ECE411T5/Practicum/Initial Prototype/KeyPad DoorLock Initial Prototype.jpg

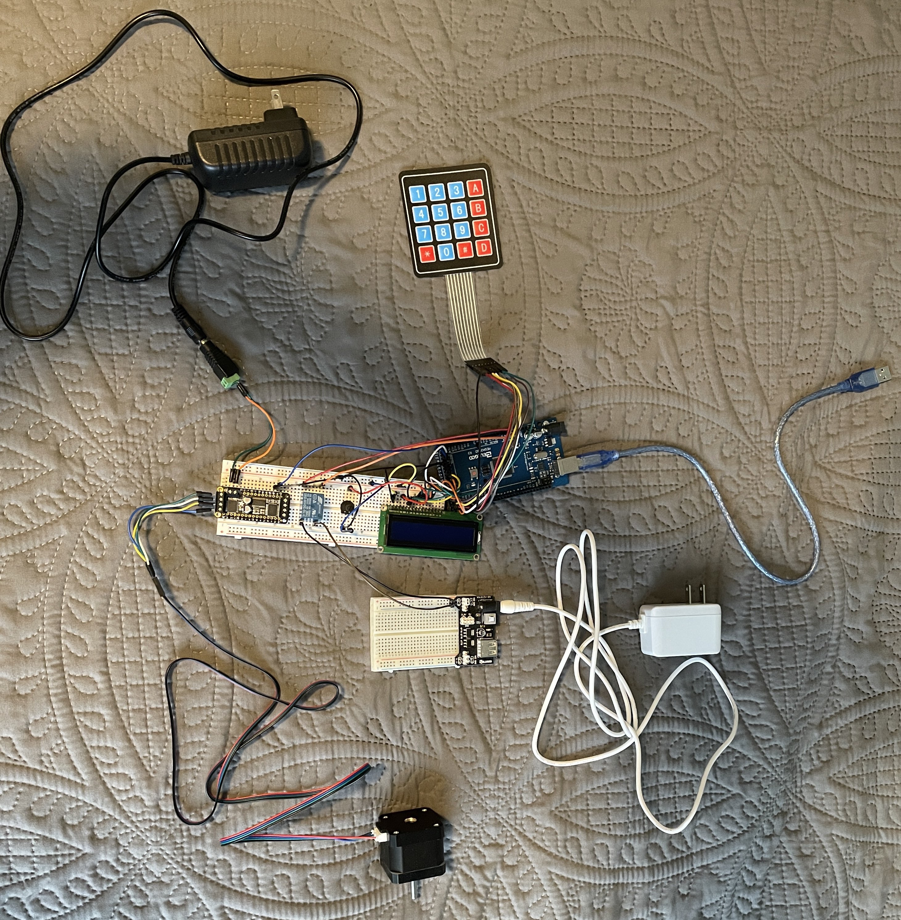
Initial Prototype/KeyPad DoorLock Initial Prototype.jpg
