ECE411T5/Practicum/README.md

# Practicum
Portland State University. Electrical and Computer Engineering Department. ECE 411 Practicum Project

## Team 5
* jdhobby       - Joshua Hobby
* CompileMyLife - Ibrahim Binmahfood
* Ghonimo       - Mohamed Ghonim
* DrFumador     - Mohamed Ashkanani
