ECE411T5/Practicum/Product Design Specifications PDS/System Architecture.pdf

ECE 411 Industry Design Processes System Architecture

Mohamed Ghonim, Ibrahim Binmahfood Joshua Hobby, Mohamed Ashkanani Team #5

Block diagram of our system.

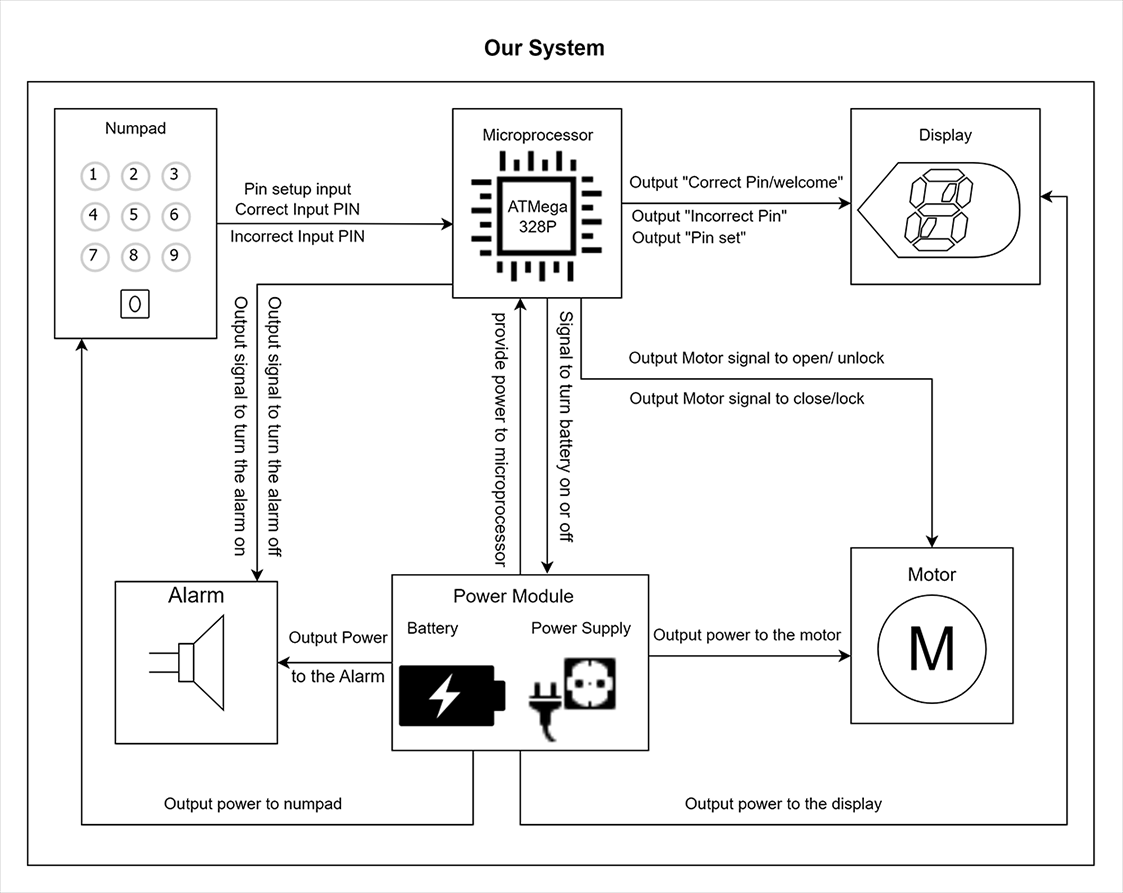
[picture p3: figure]

Block diagram of our system. (2)

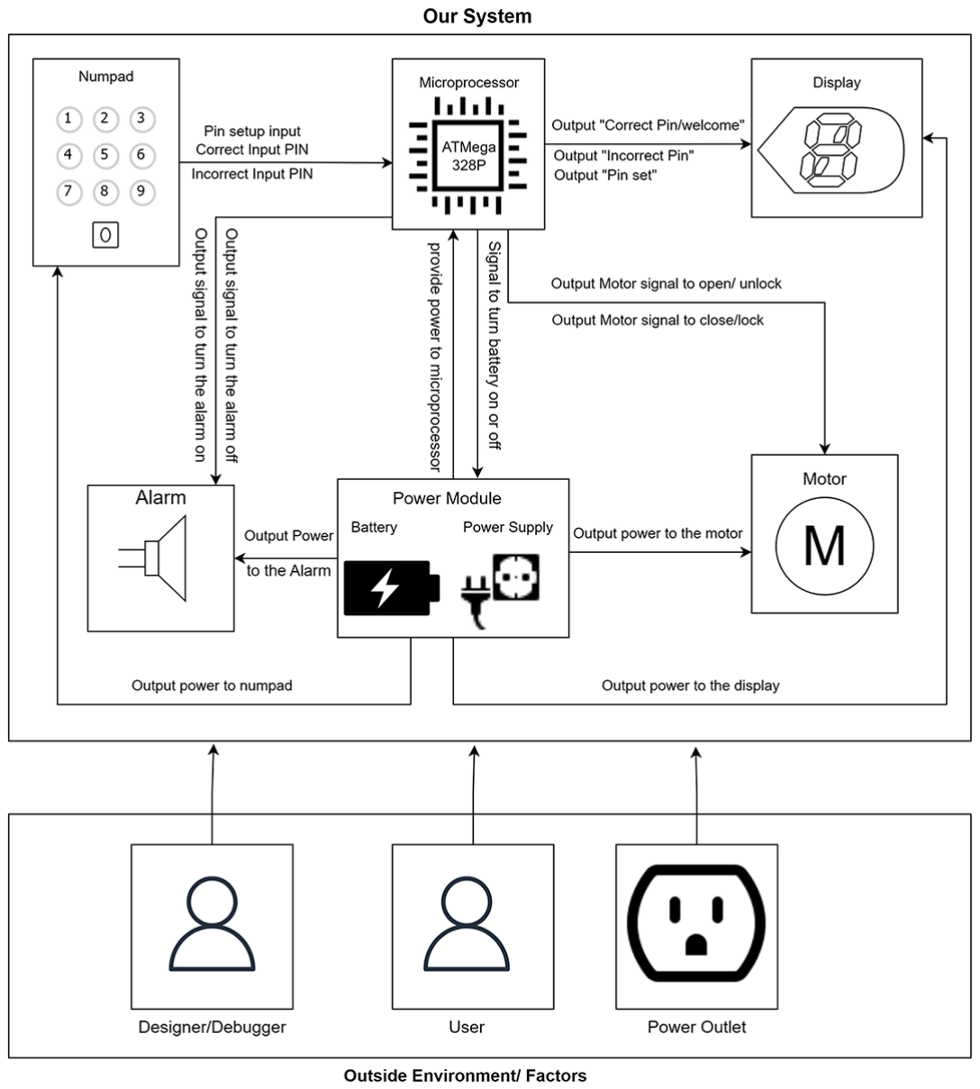
[picture p4: figure]

Block diagram with our “potential” fingerprint sensor additional feature.

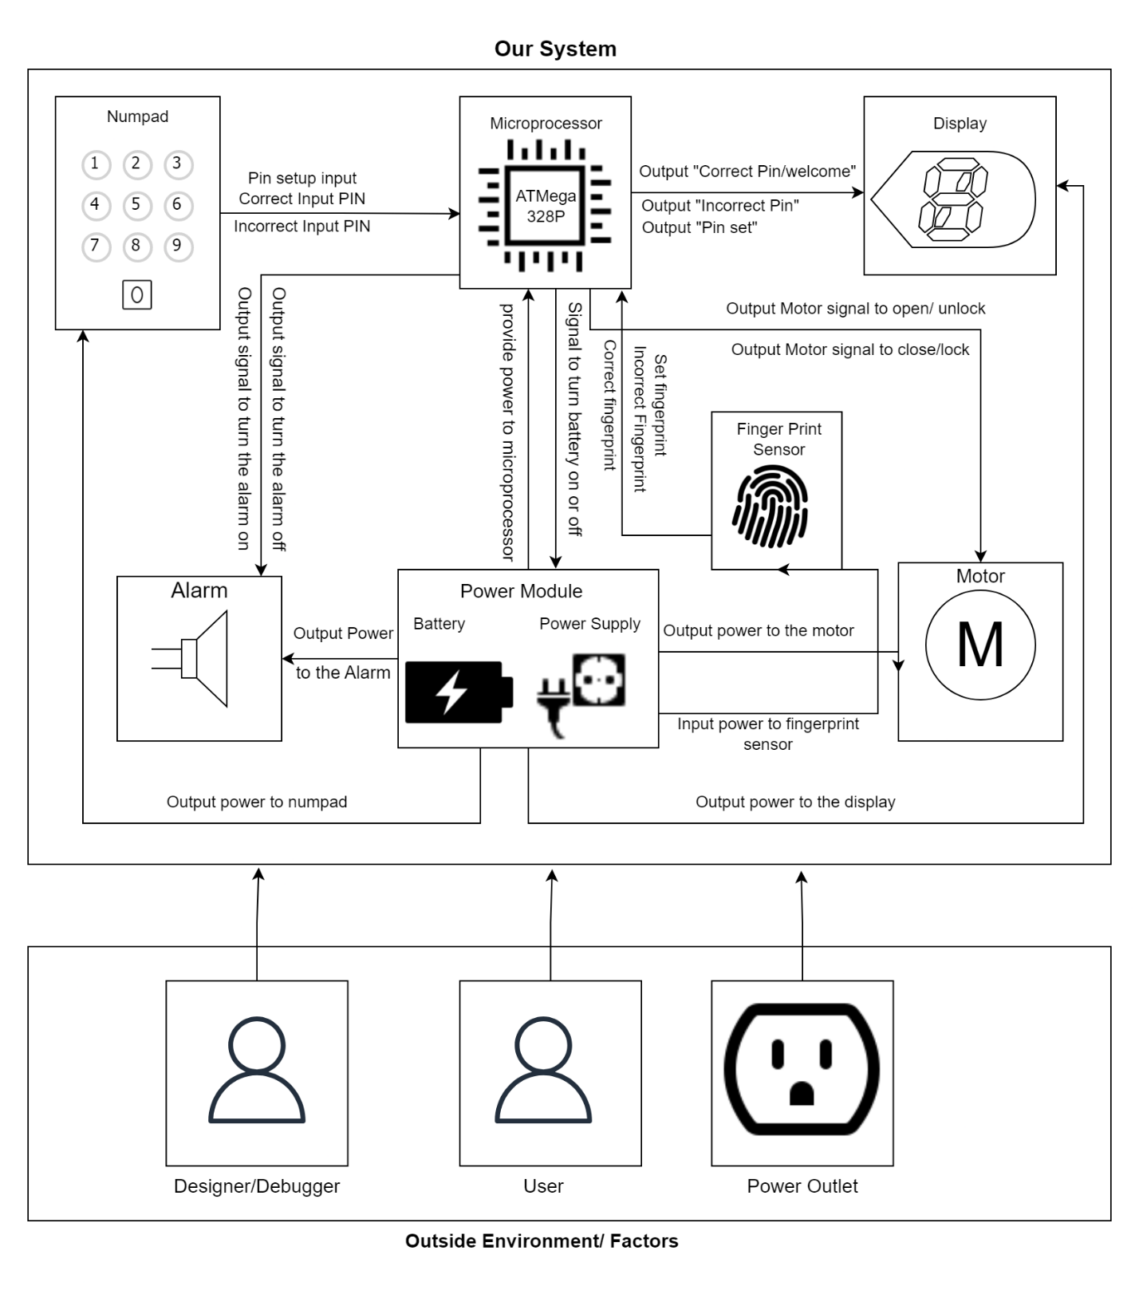
[picture p5: figure]
