ECE411T5/Practicum/ECE411_schedule.pdf

ECE411 Practicum Project | Dec 8, 2022
Portland State University | http://github.com/ECE411T5/Practicum
Project manager | Joshua Hobby, Mohamed Ghonim, Ibrahim Binmahfood, Mohamed Ashkanani
Project dates | Oct 31, 2022 - Dec 9, 2022
Completion | 89%
Tasks | 18
Resources | 4

Name | Begin date | End date
Set Gantt Chart | 10/31/22 | 10/31/22
Breadboard Prototype | 11/1/22 | 11/3/22
Updated Schematic and Layout | 11/2/22 | 11/3/22
Rough Programming | 11/3/22 | 11/11/22
Finalize BOM | 11/3/22 | 11/8/22
CAD draft Draft looks good. Design Review went well. | 11/7/22 | 11/9/22
Functional Decomposition | 11/8/22 | 11/9/22
Order missing parts for BOM | 11/9/22 | 11/10/22
Finalize programming FInal code uploaded | 11/14/22 | 11/21/22
CAD finalized | 11/10/22 | 11/14/22
Verify all parts recieved | 11/15/22 | 11/21/22
3d Print Enclosure Late. Got final print 12/6 | 11/15/22 | 11/22/22
Design Review | 11/16/22 | 11/17/22
Send PCB design to lab | 11/17/22 | 11/17/22
Construct Circuit PCB came in late. Could not start constructing on time. Issues with construction. Power supply adaptor missing. | 11/21/22 | 11/25/22
Test plan design Documentation on Github for test plans | 11/22/22 | 11/29/22
Test project Troubleshooting issues with implementing ATMega328 on PCB. MIcrocontroller works on Arduino,but does not transfer to board well. | 11/30/22 | 12/6/22
Final Presentation | 12/7/22 | 12/8/22
ECE411 Practicum Project | Dec 8, 2022
Tasks | 2

Name | Default role
Joshua Hobby | project manager
Mohamed Ghonim | project manager
Ibrahim Binmahfood | project manager
Mohamed Ashkanani | project manager

## Resources

## Gantt Chart

Name | Begin date | End date
Set Gantt Chart | 10/31/22 | 10/31/22
Breadboard Prototype | 11/1/22 | 11/3/22
Updated Schematic and Layout | 11/2/22 | 11/3/22
Rough Programming | 11/3/22 | 11/11/22
Finalize BOM | 11/3/22 | 11/8/22
CAD draft | 11/7/22 | 11/9/22
Functional Decomposition | 11/8/22 | 11/9/22
Order missing parts for BOM | 11/9/22 | 11/10/22
Finalize programming | 11/14/22 | 11/21/22
CAD finalized | 11/10/22 | 11/14/22
Verify all parts recieved | 11/15/22 | 11/21/22
3d Print Enclosure | 11/15/22 | 11/22/22
Design Review | 11/16/22 | 11/17/22
Send PCB design to lab | 11/17/22 | 11/17/22
Construct Circuit | 11/21/22 | 11/25/22
Test plan design | 11/22/22 | 11/29/22
Test project | 11/30/22 | 12/6/22
Final Presentation | 12/7/22 | 12/8/22
10'22 November 2022 | December 2022

31

1

2

3
4

7

8

9 | 10 | 11 | 14 | 15 | 16 | 17 | 18 | 21 | 22 | 23 | 24 | 25 | 28 | 29 | 30

1

2
5

6
7

8

9 | 12 | 13 | 14 | 15 | 16
Set Gantt Chart | Functional Decomposition | Finalize programming | Construct Circuit | Test project

## Resources Chart

Name | Default role
Joshua Hobby | project man...

Set Gantt Chart

Final Presentation

Order missing parts for B...

Verify all parts recieved

Design Review

Construct Circuit

Test plan design

Test project

Functional Decomposition

Rough Programming

Finalize programming

Mohamed Ghonim | project man...

Updated Schematic and ...

Final Presentation

Order missing parts for B...

Design Review

Test plan design

Test project

Functional Decomposition

CAD finalized

Send PCB design to lab

Finalize programming

Ibrahim Binmahfood | project man...

Breadboard Prototype

200% | 200% | 200% | 200% | 300%
200% | 300% | 200% | 200% | 200%
200% | 200% | 200% | 300% | 200% | 200%
10'22 November 2022 | December 2022
31 1 2 3 4 | 7 8 9 10 11 | 14 15 16 17 18 | 21 22 23 24 25 | 28 29 30 1 2 | 5 6 7 8 9 | 12 13 14 15 16
| 200% 300% 200% | 200% 300% 200% | 300% 200%
