ECE411T5/Practicum/0 - Final CAD V2.3.1/3 - CAD DRC-ERC Pics/No_ERC_Violations.jpg

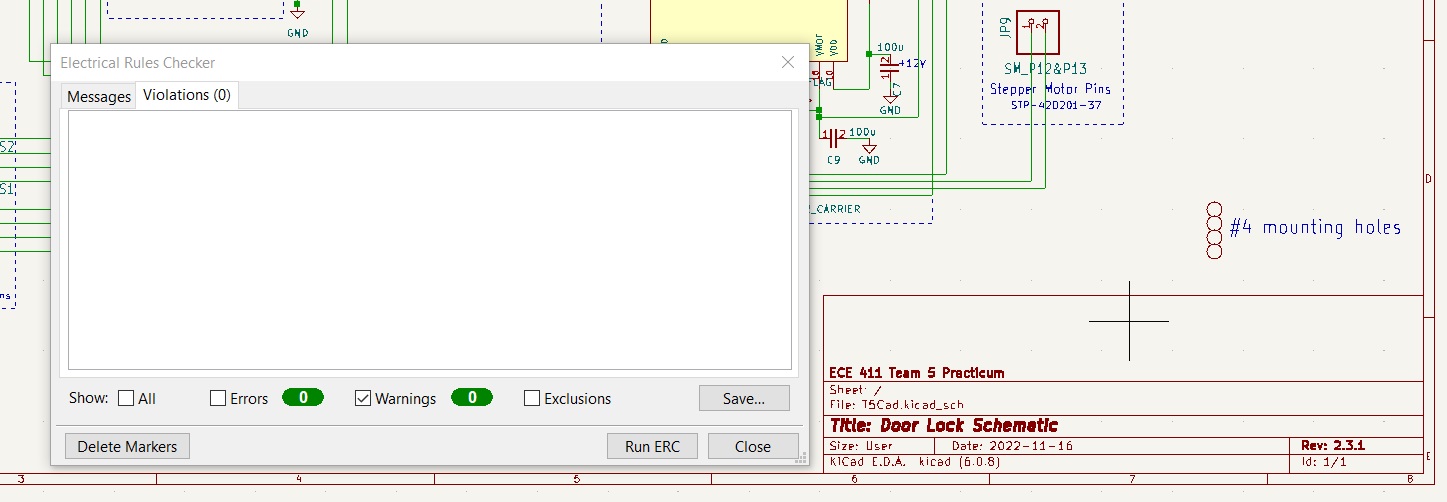
0 - Final CAD V2.3.1/3 - CAD DRC-ERC Pics/No_ERC_Violations.jpg
