ECE411T5/Practicum/0 - Final CAD V2.3.1/3 - CAD DRC-ERC Pics/Schematic Screenshot.jpg

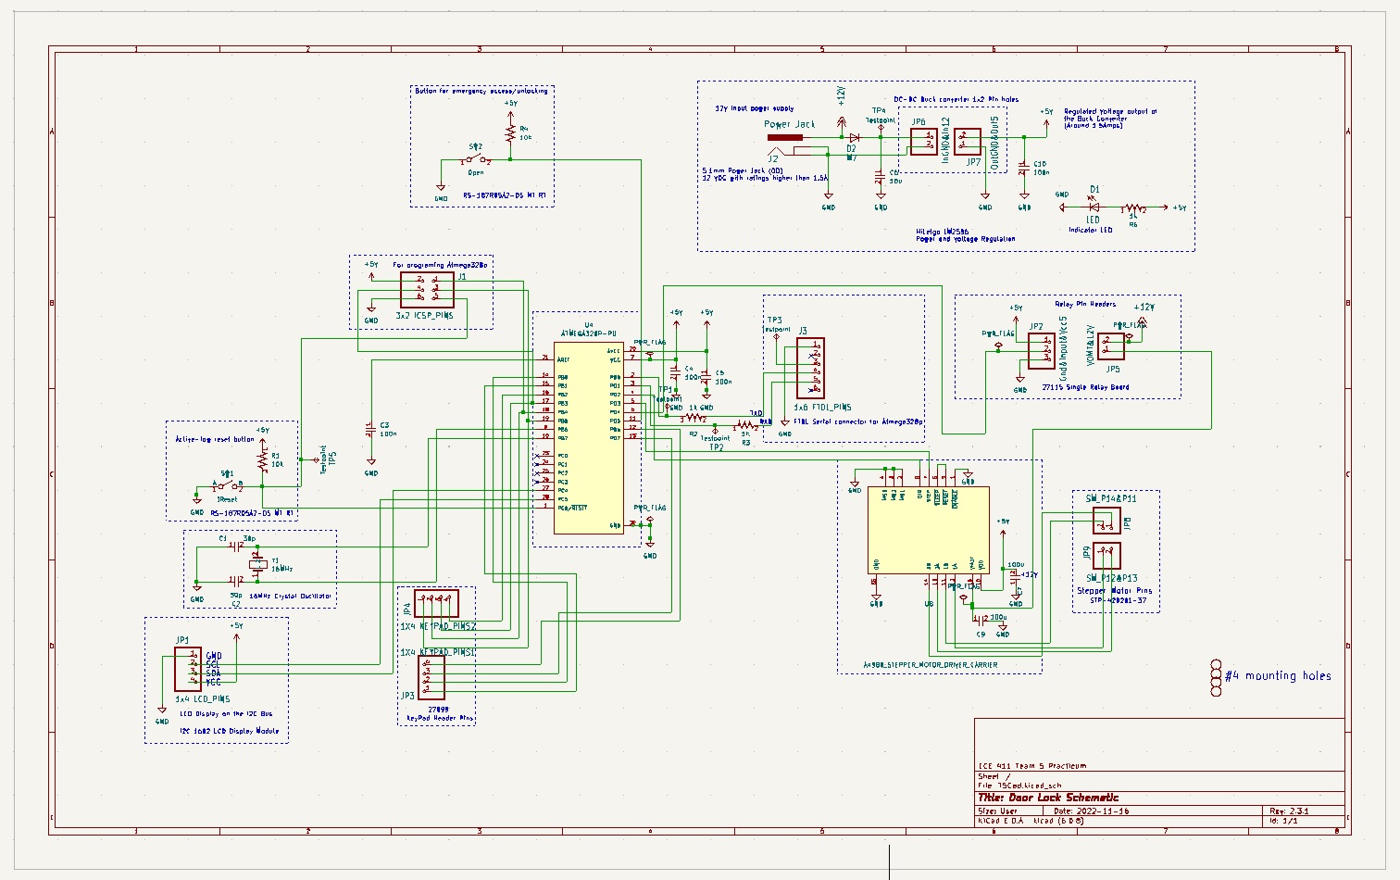
0 - Final CAD V2.3.1/3 - CAD DRC-ERC Pics/Schematic Screenshot.jpg
