ECE411T5/Practicum/Level 1 Block Diagrams/Door Lock with Alarm Block DiagramC.png

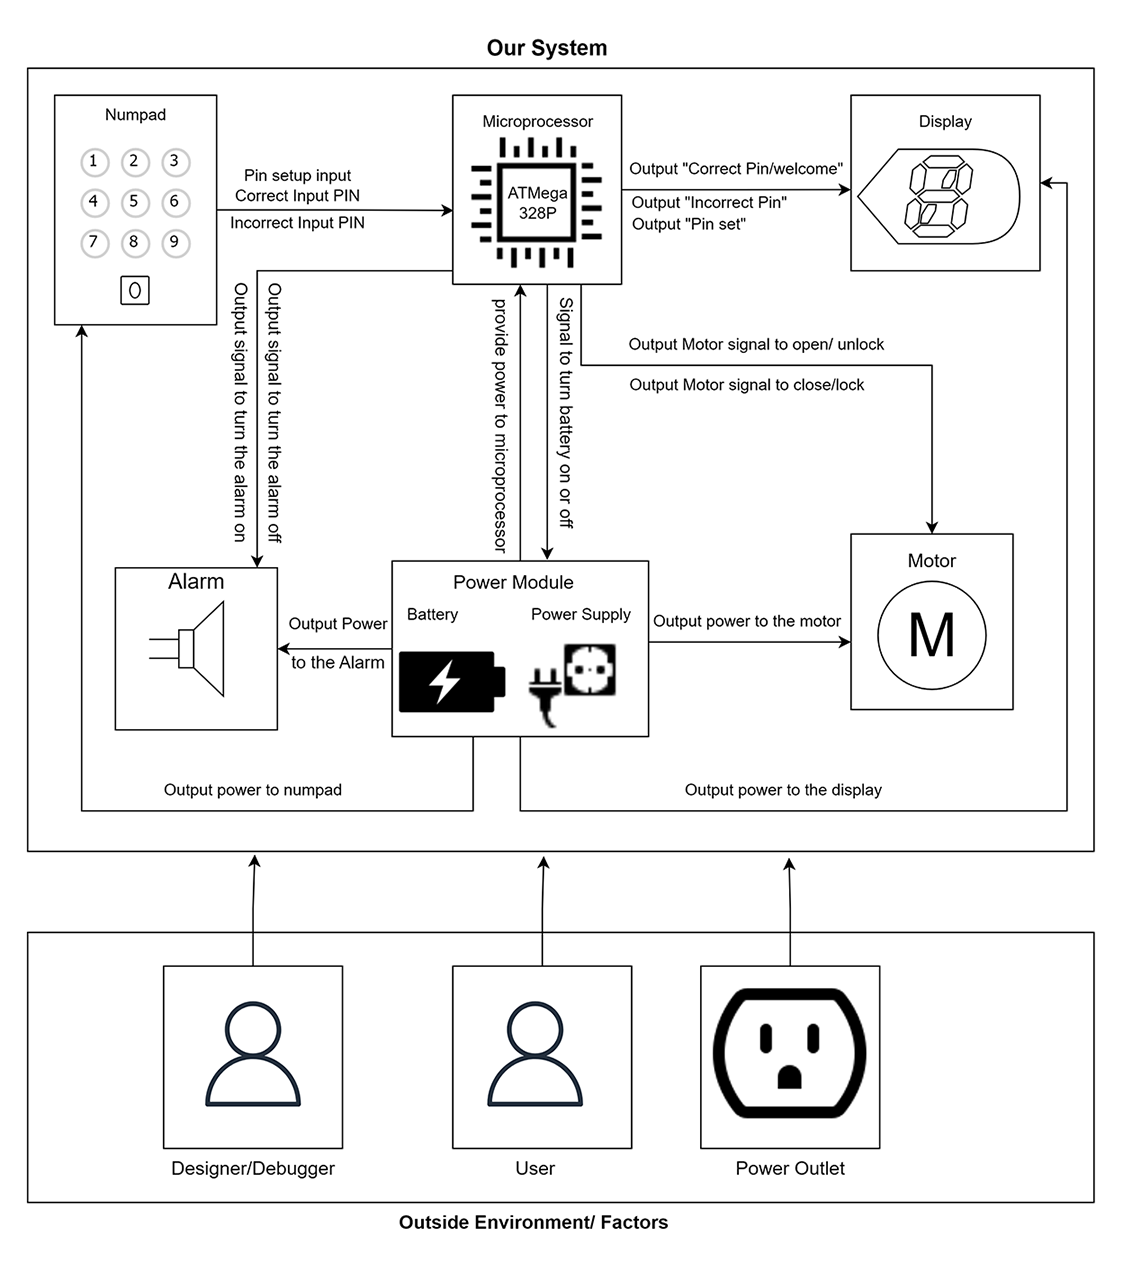
Level 1 Block Diagrams/Door Lock with Alarm Block DiagramC.png
