ECE411T5/Practicum/PCB Layout/Preliminary_3D_Layout_Back.png

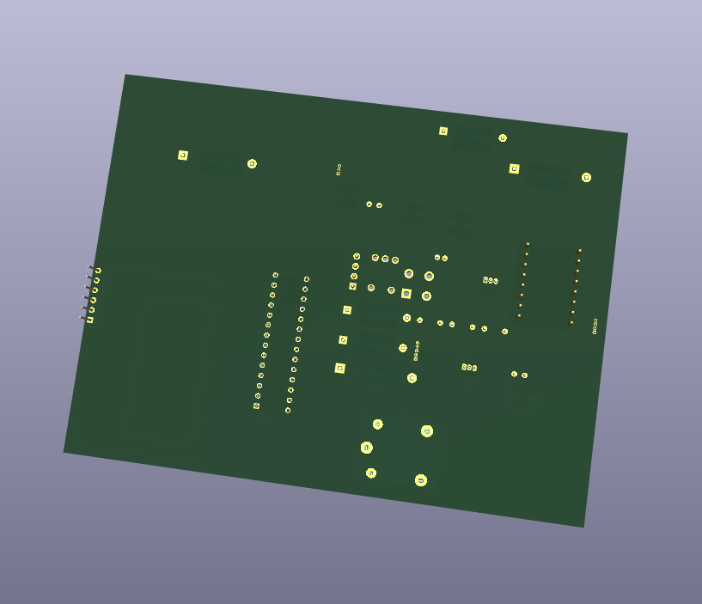
PCB Layout/Preliminary_3D_Layout_Back.png
