ECE411T5/Practicum/PCB Layout/Preliminary_3D_Layout_Front.png

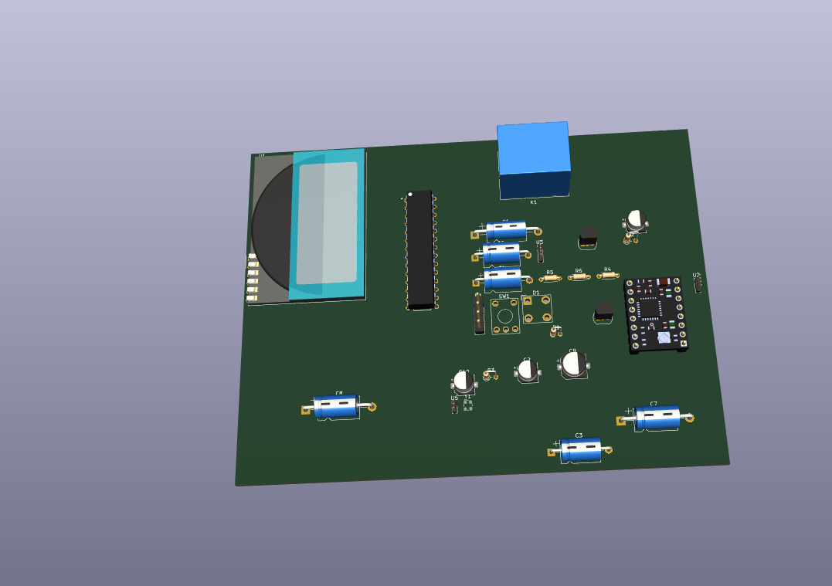
PCB Layout/Preliminary_3D_Layout_Front.png
