ECE411T5/Practicum/PCB Layout/Preliminary_PCB.jpg

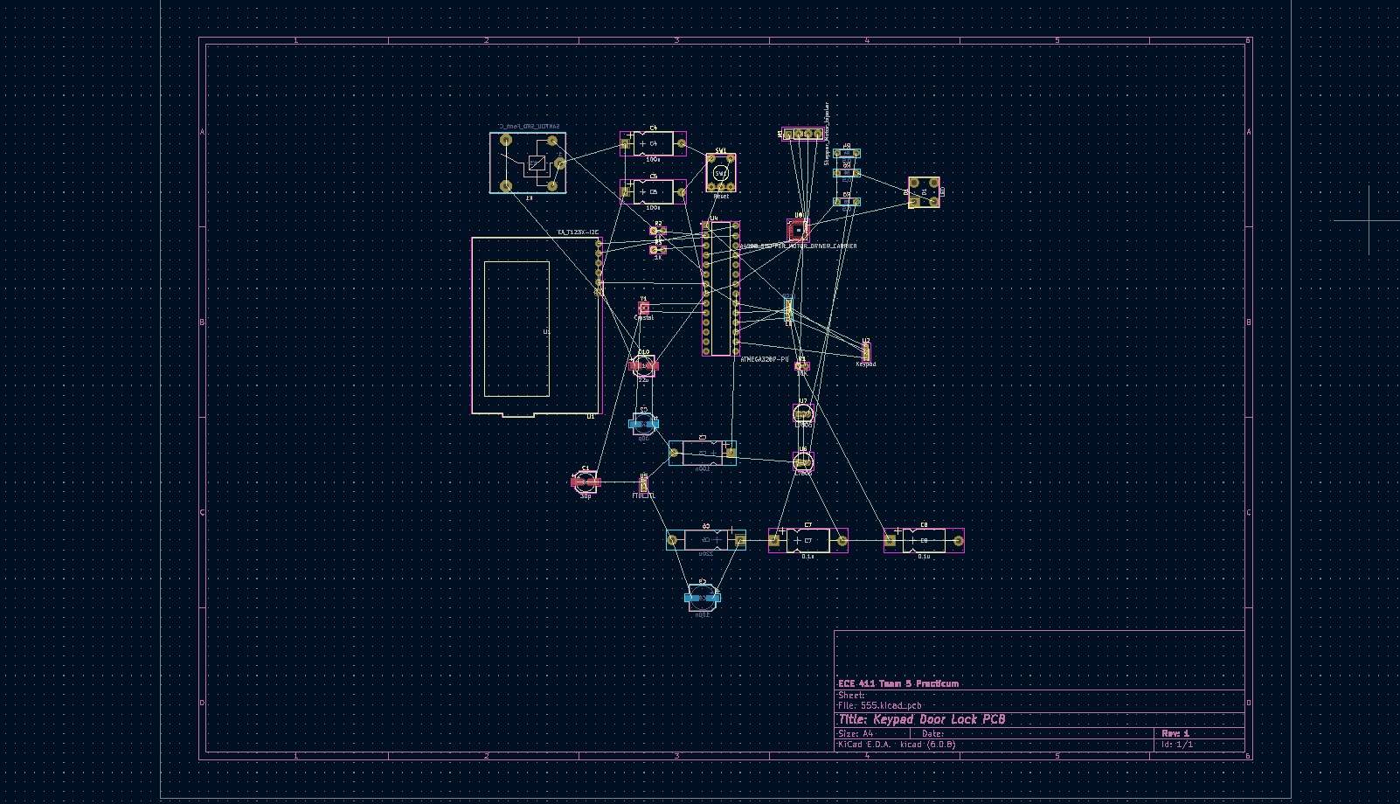
PCB Layout/Preliminary_PCB.jpg
