ECE411T5/Practicum/Updated Schematic/No_errors.png

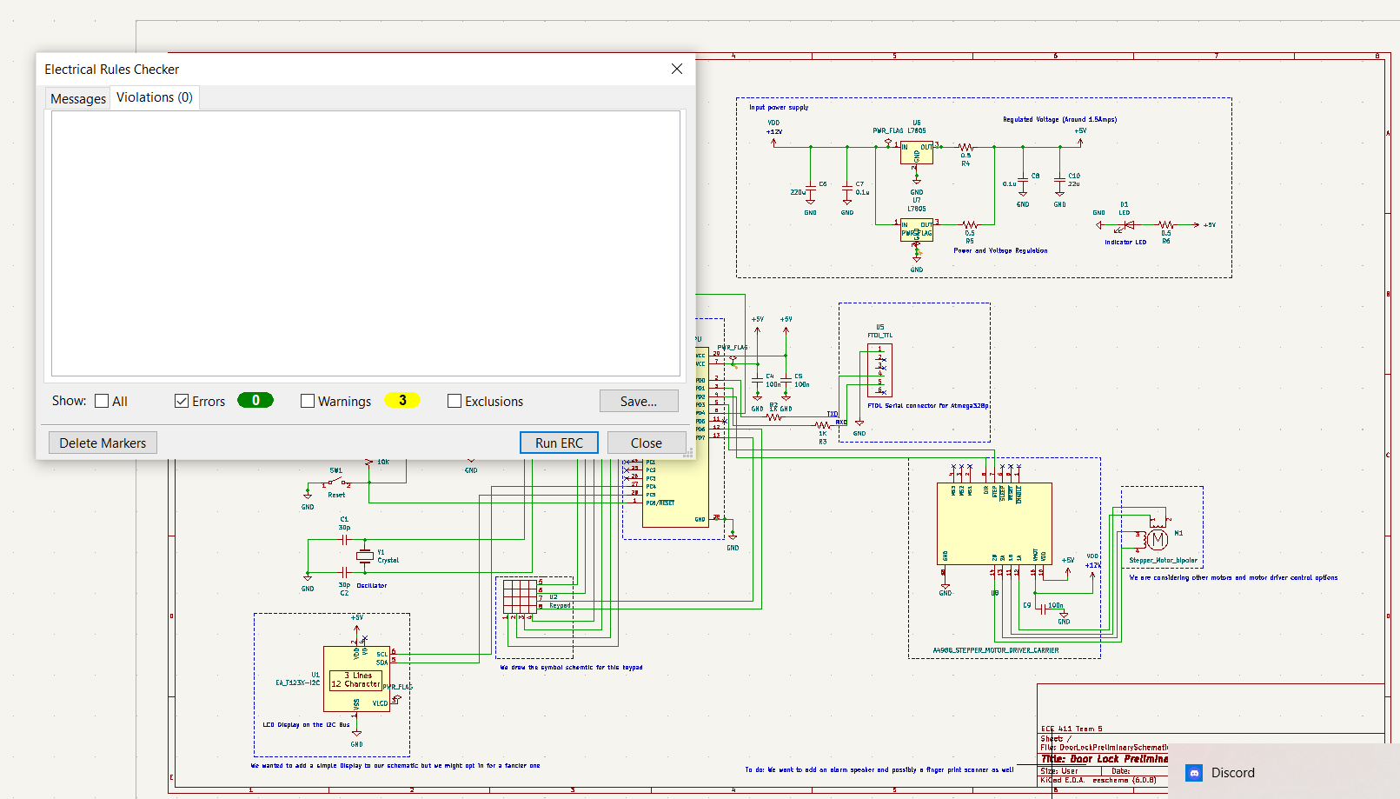
Updated Schematic/No_errors.png
