ECE411T5/Practicum/Bill Of Materials (BOM)/ECE 411 - BOM - Revision#4 - Team 5.xlsx

Bill Of Materials for: [Practicum Group 5] [TEAM NAME]
Last modified: [12/08/2022]
PCB version: [PCB VERSION #4]
BOM revision: [BOM REVISION #4] |  | P/NP | = Place/Not Place (components marked NP are not stuffed on the board)
Cnt | Part References | P/NP | Mfg | Device | Mfg PN | Description | Dist | Dist Part Number | Cost Ea. | Cost Total
1 | U4 | P | Microchip | ATMEGA328P-PU | ATMEGA328P-PU | MICROCONTROLLER | Amazon | N/A | $13.50 | $13.50
1 | U1 | P | JOYNANO | Stepper motor | N/A | JoyNano Nema 17 Stepper Motor Integrated 310mm T8 Lead Screw | Amazon | ‎M42SH40-1684A | $12.99 | $12.99
1 | U2 | P | Pololu | A4988_STEPPER_MOTOR_DRIVER_CARRIER | 1182 | Stepper motor controler; IC: A4988; 1A; Uin mot: 8÷35V | Pololu | 1182 | $14.45 | $14.45
1 | U4 | P | Parallax | Single Relay Board | 27115 | Single Relay Board | Mouser | 619-27115 | $9.99 | $9.99
2 | IC1, IC2 | P | Texas Instruments | LM7805S/NOPB | LM7805S/NOPB | IC REG LINEAR 5V 1.5A | Digi-key | 296-49741-ND | $2.27 | $4.54
1 | U2 | P | GeeekPi | 16x2 White on Blue Character LCD | N/A | 16x2 White on Blue Character LCD | Amazon | N/A | $10.99 | $10.99
1 | U3 | P | Parallax | KEYPAD4X4 | 27899 | SWITCH KEYPAD 16 KEY NON-ILLUM | Crystalfontz | CFAH1602B-TMI-JT | $7.95 | $7.95
1 | D2 | P | Würth Elektronik | LEDCHIP-LED0805 | 150080GS75000 | LED | Mouser | 710-150080GS75000 | $0.19 | $0.19
1 | SW1 | P | C&K | SWITCH-MOMENTARY-2SMD | RS-187R05A2-DS MT RT | Various NO switches- pushbuttons, reed, etc | Digi-key | CKN10361TR-ND | $0.64 | $0.64
1 | SW2 | P | C&K | SWITCH-MOMENTARY-2SMD | RS-187R05A2-DS MT RT | Various NO switches- pushbuttons, reed, etc | Digi-key | CKN10361TR-ND | $0.64 | $0.64
1 | X1 | P | ECS | CRYSTALSMD-HC49UP | ECS-160-18-5PX-TR | Crystals (Generic) | Digi-key | XC2081TR-ND | $0.45 | $0.45
2 | R1, R2 | P | Yageo | R-US_R0805 | RC0805FR-0710KL | 10 kOhms ±1% 0.125W, 1/8W Chip Resistor 0805 (2012 Metric) Moisture Resistant Thick Film | Digi-key | 311-10.0KCRTR-ND | $0.10 | $0.20
3 | R3, R4, R5 | P | Yageo | R-US_R0805 | RC0805FR-071KL | RES 1K OHM 1% 1/8W 0805 | Digi-key | 311-1.00KCRTR-ND | $0.10 | $0.30
4 | C1, C2, C3, C4 | P | Samsung Electro-Mechanics | C-EUC0805K | CL21B104KBCNNNC | CAP CER 100nF 50V X7R 0805 | Digi-key | 1276-1003-2-ND | $0.10 | $0.40
2 | C5, C6 | P | Samsung Electro-Mechanics | C-EUC0805K | CL32Z107MQV6PNE | CAPACITOR, European symbol | Digi-key | 1276-CL32Z107MQV6PNETR-ND | $0.10 | $0.20
1 | C7 | P | Samsung Electro-Mechanics | C-EUC0805K | CL31B106KLHNNNE | 10 µF ±10% 35V Ceramic Capacitor X7R 1206 (3216 Metric) | Digi-key | 1276-3103-2-ND | $0.66 | $0.66
2 | C8, C9 | P | Samsung Electro-Mechanics | C-EUC0805K | CL21C300JBANNNC | CAP CER 30PF 50V C0G/NP0 0805 | Digi-key | 1276-1130-2-ND | $0.10 | $0.20
1 | J1 | P | Harwin | PINHD-2X3 | M20-9980345 | PIN HEADER | Digi-key | 952-2120-ND | $0.34 | $0.34
1 | J2 | P | Sullins | PINHD-1X6 | PRPC006SAAN-RC | PIN HEADER | Digi-key | S1011EC-06-ND | $0.19 | $0.19
1 | J1 | P | HiLetgo | LM2596 Adjustable DC-DC Step Down Buck Power Convert | N/A | Power Converter Module 4.0-40V to 1.25-37V LED Voltemeter | Amazon | N/A | $5.25 | $5.25
1 | J3 | P | HiLetgo | AVR ISP | N/A | USBTiny USBtinyISP AVR ISP Programmer 6/10 Pin Bootloader for Arduino UNO MEGA | Amazon | N/A | $9.19 | $9.19
1 | Exterior | P | EPL | 3D printed eterior for the device | N/A | A small 3D printed device with hole for the getting power and the LCD display | EPL | N/A | $8.00 | $8.00
 |  |  |  |  |  |  |  |  | Sum | $93.26
VERSION INFO
Rev | Date | Notes
1.0r3 | 2022-12-08 | Add some new components to the list
1.0r2 | 2022-11-20 | Update some wrong components
1.0r1 | 2022-11-10 | Cleaned up parts, fixed mistakes, rough draft of board
1.0r0 | 2022-10-31 | Initial BOM, an simple list of all the components required. Dist Part Number and cost were not determined
