ECE411T5/Practicum/Preliminary Schematic/Door Lock Preliminary Schematic.pdf

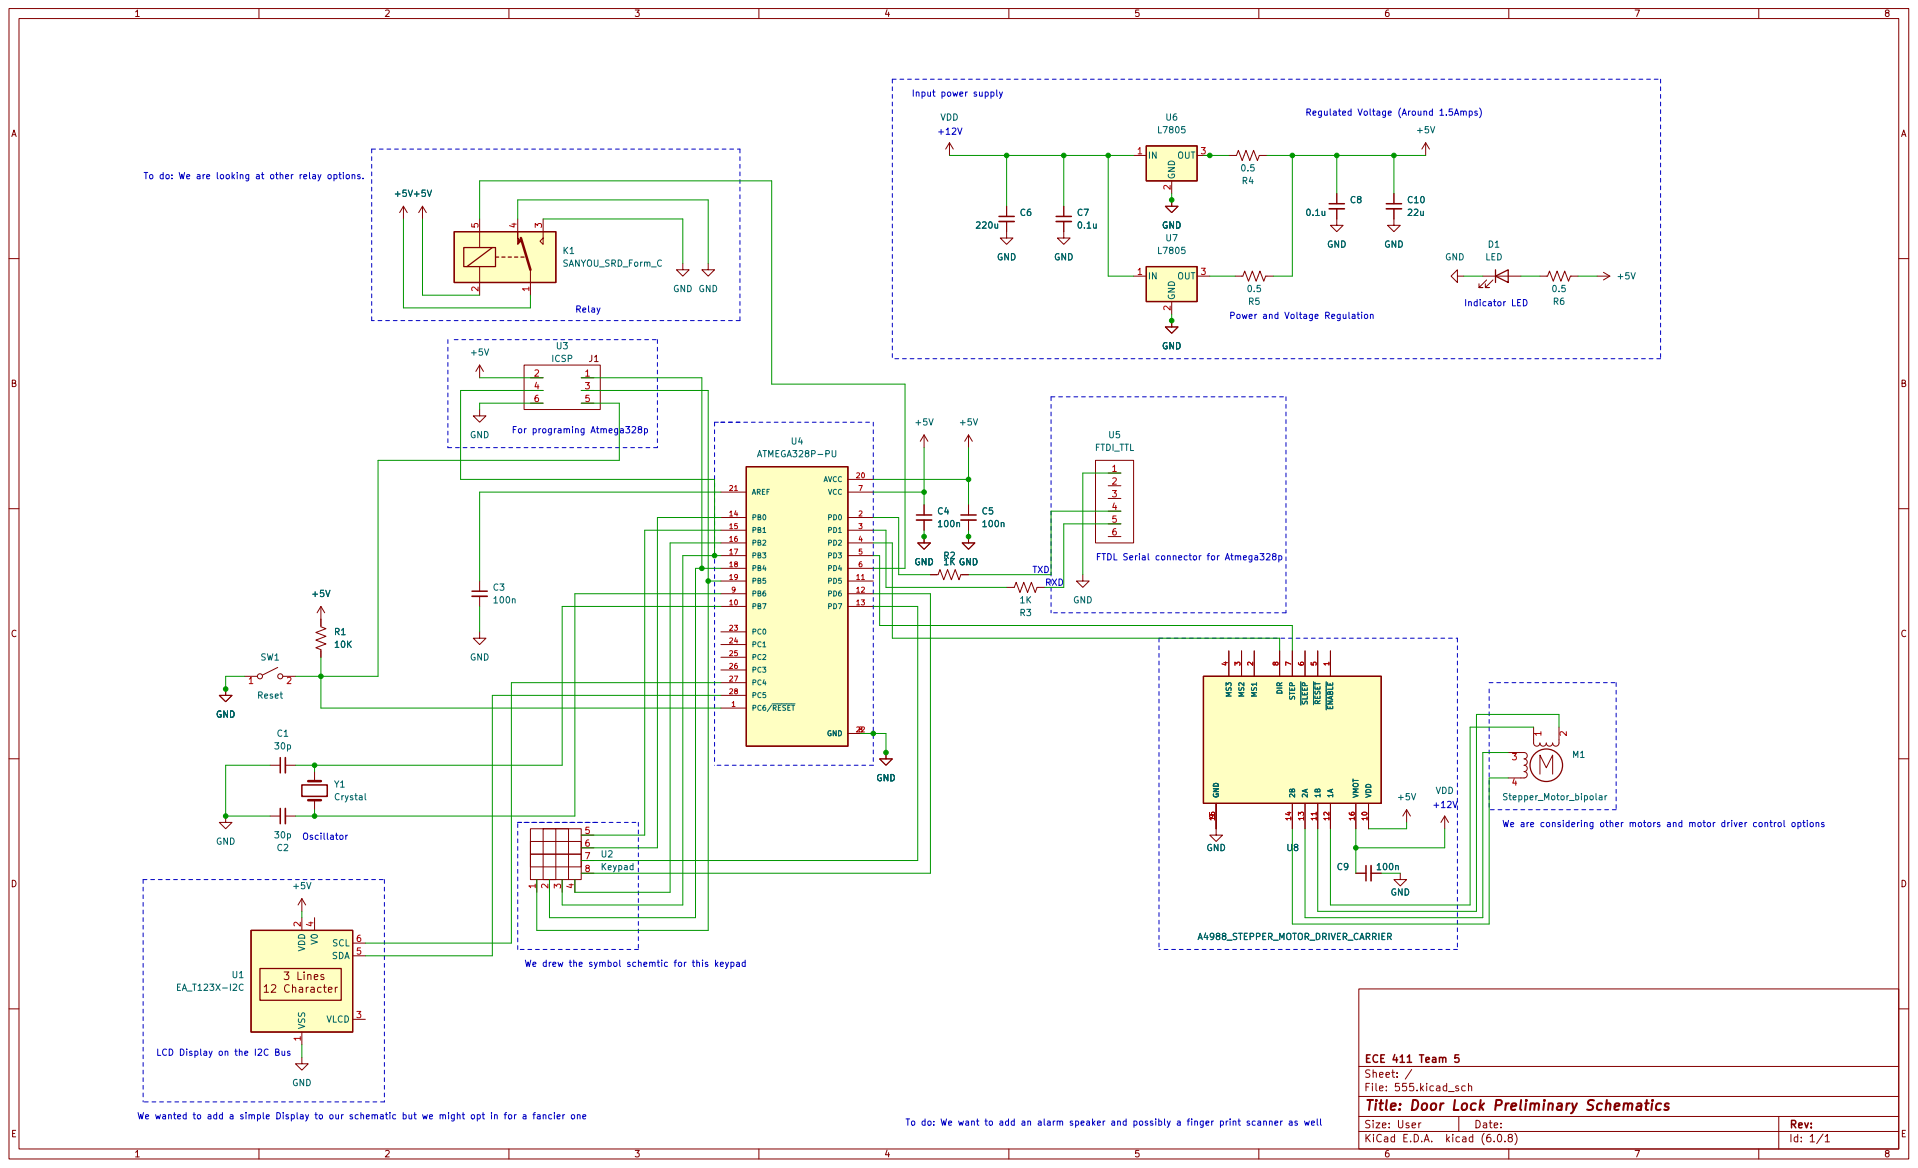
[picture p22: page 1]

To do: We are looking at other relay options.

Power and Voltage Regulation

FTDL Serial connector for Atmega328p GND

We drew the symbol schemtic for this keypad

LCD Display on the I2C Bus

File: 555.kicad_sch Sheet: / ECE 411 Team 5

Id: 1/1 Title: Door Lock Preliminary Schematics

We wanted to add a simple Display to our schematic but we might opt in for a fancier one
