ECE411T5/Practicum/Rough Cad2/Schematic.pdf

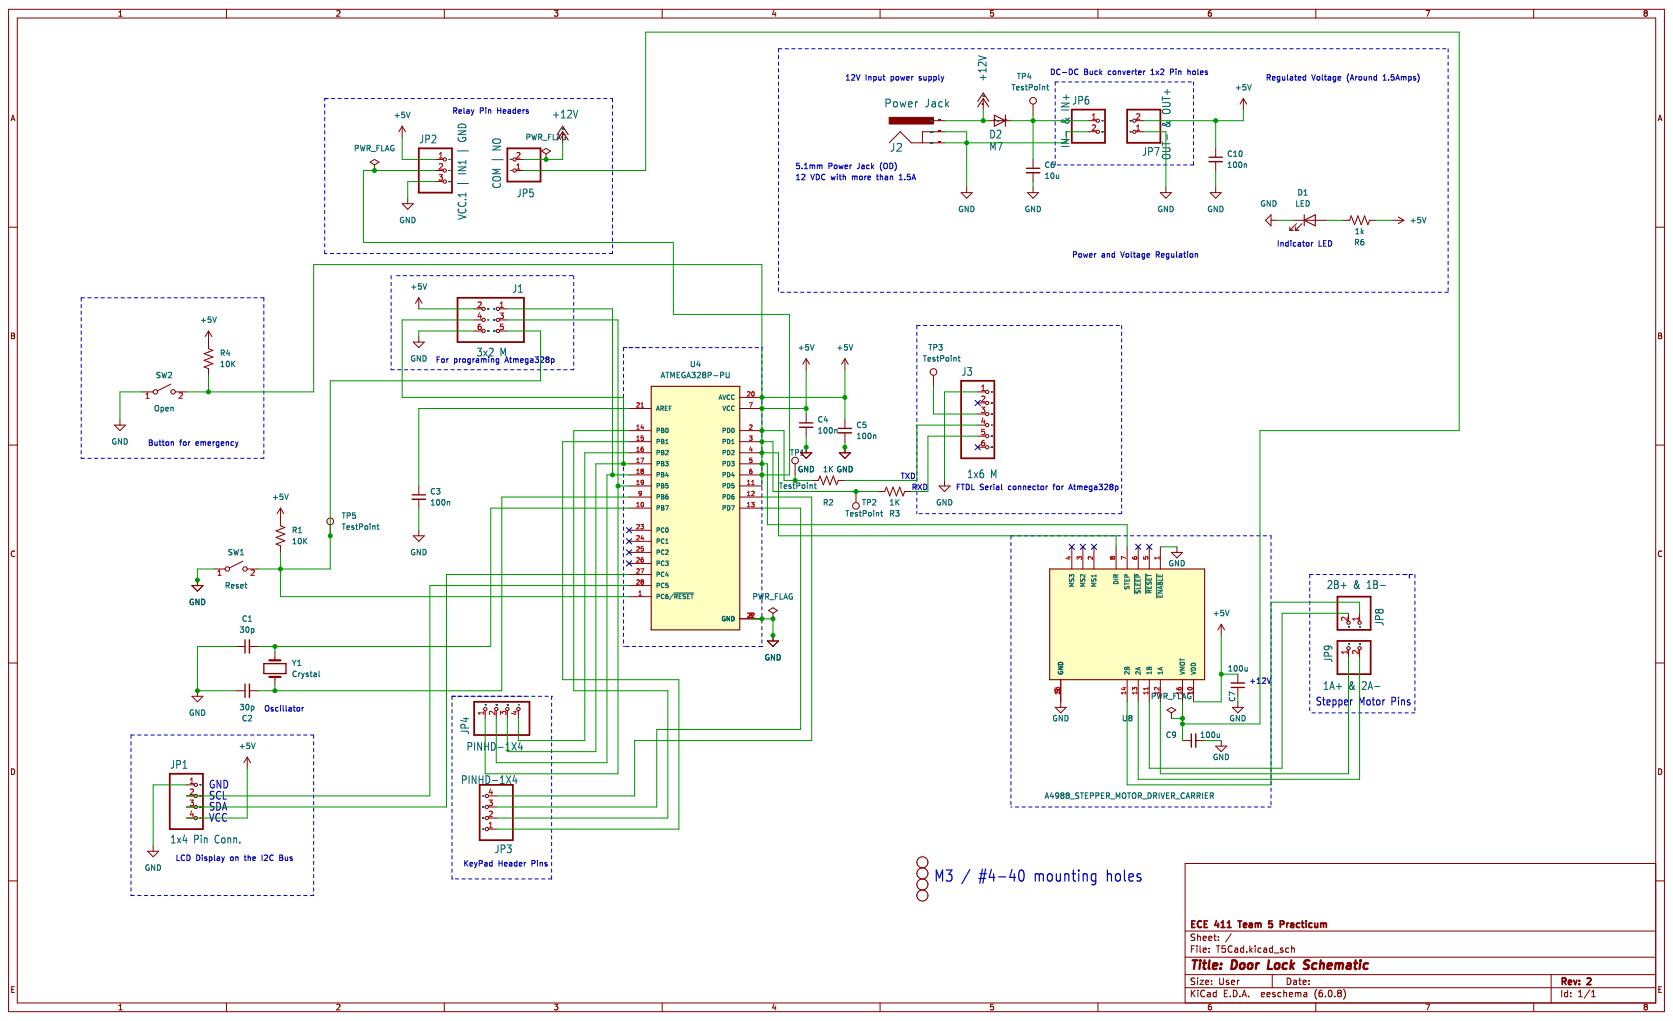
[picture p25: page 1]
