ECE411T5/Practicum/Updated Schematic/ECE411T5DoorLockSchematic.pdf

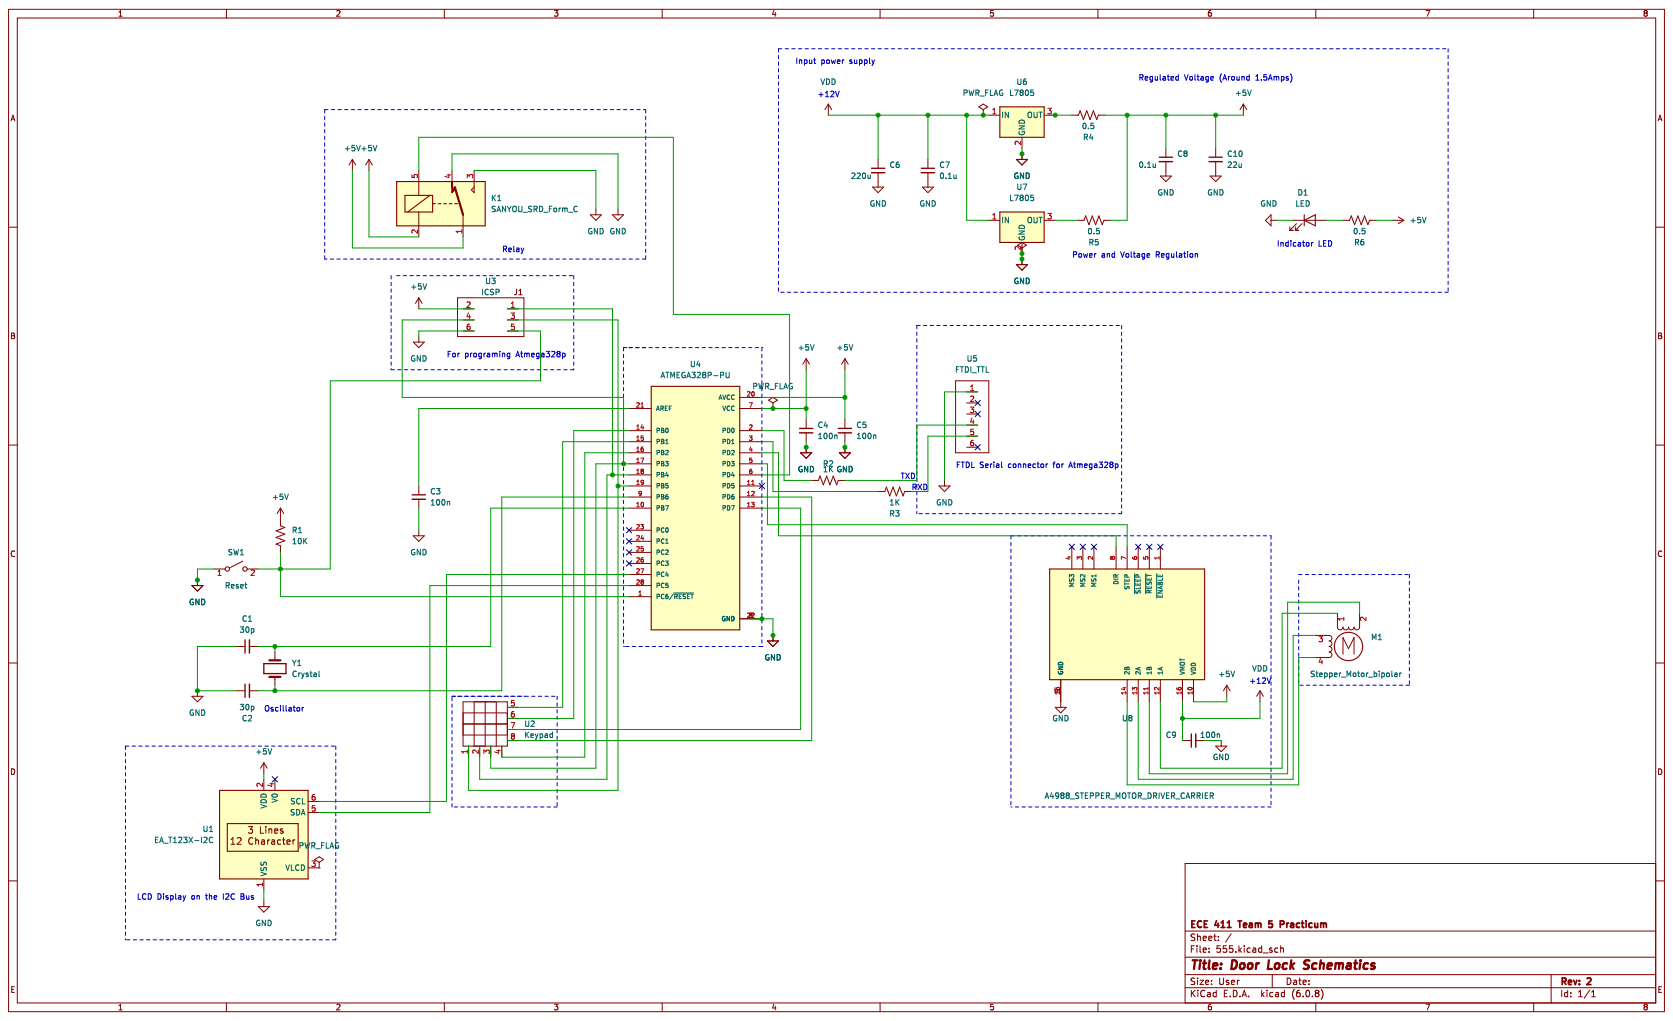
[picture p26: page 1]
