ECE411T5/Practicum/0 - Final CAD V2.3.1/0 - PDFs/0 - T05 - Final Schematic V2.3.1.pdf

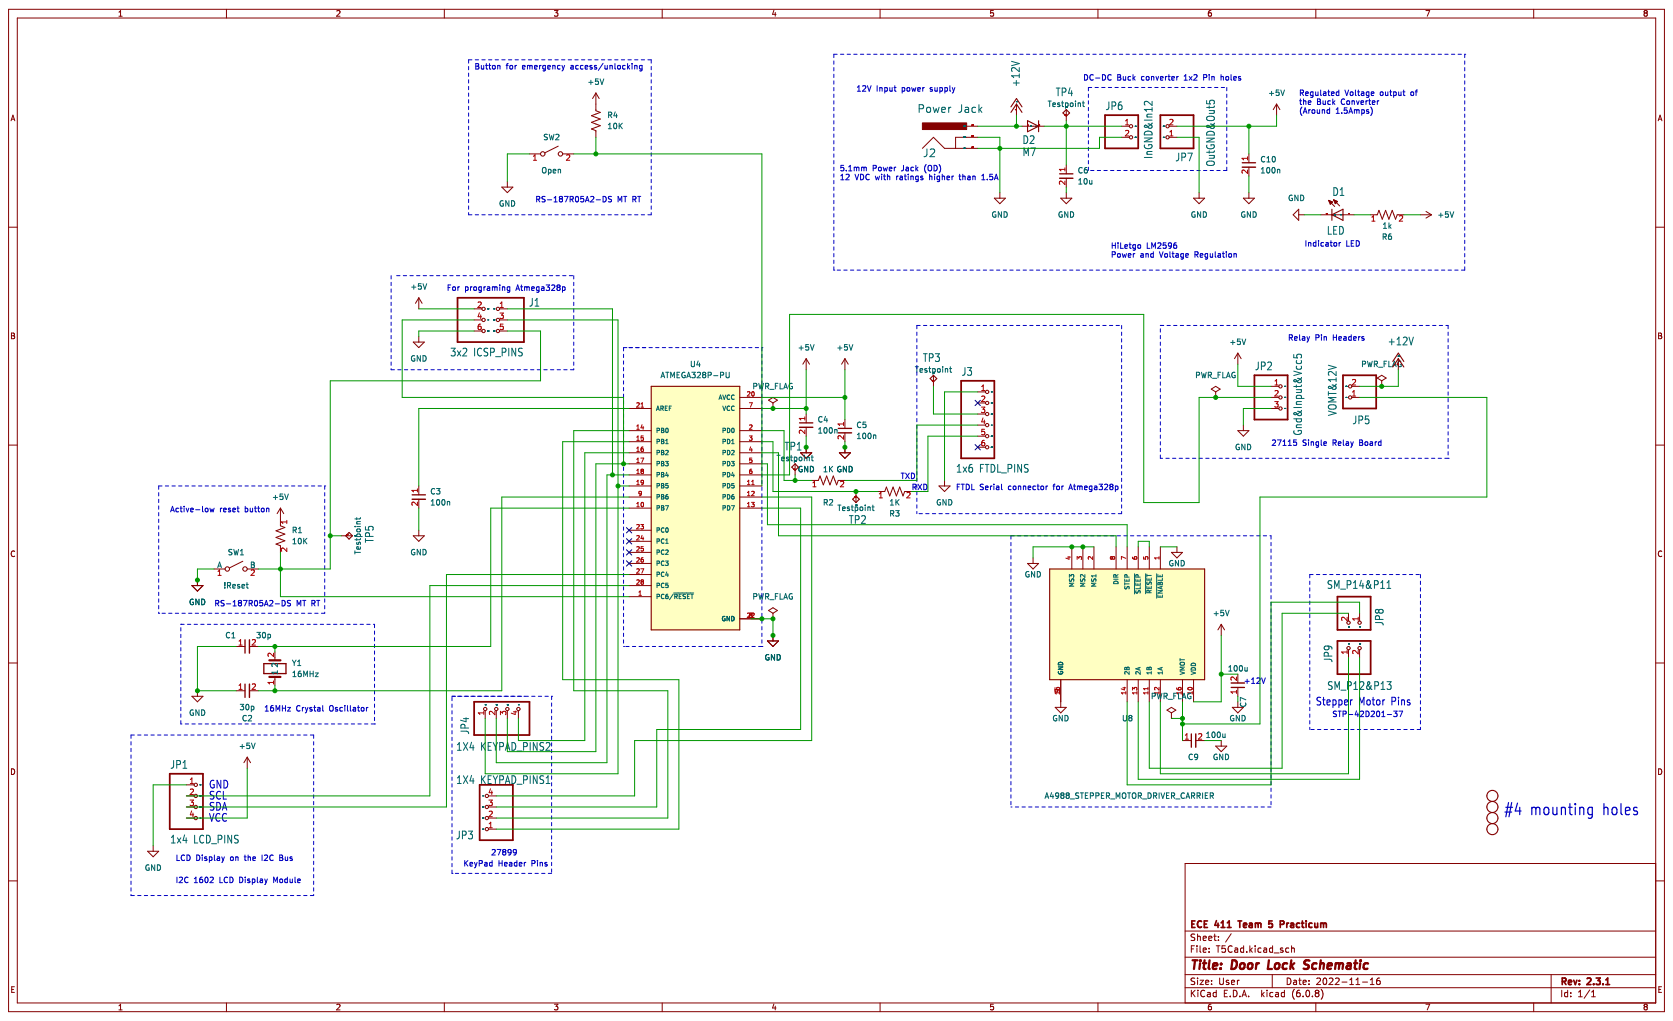
[picture p29: page 1]
