ECE411T5/Practicum/Rough Cad2/Layout.pdf

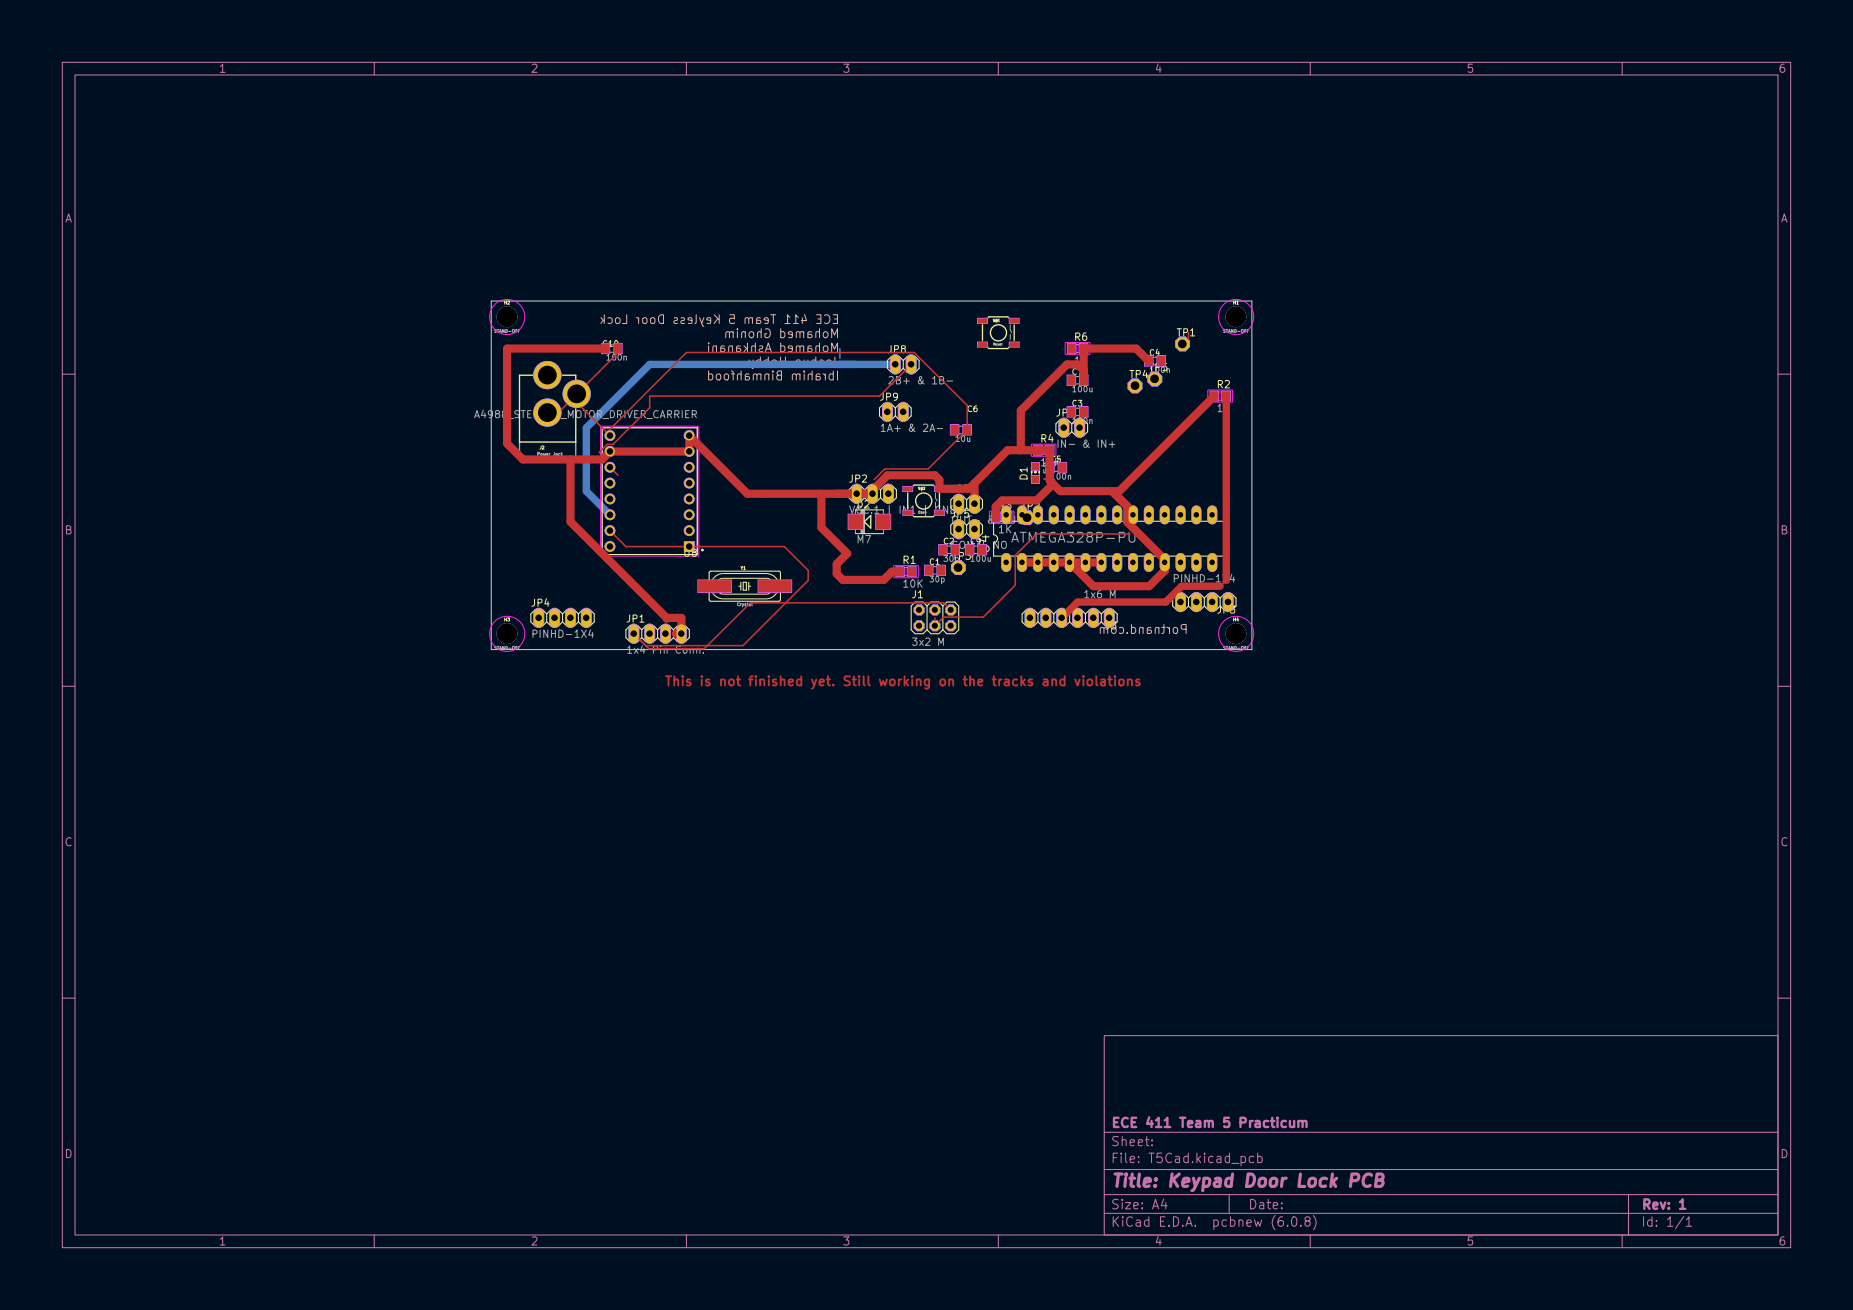
[picture p30: page 1]
