ECE411T5/Practicum/Rough Cad2/Layout_NB.pdf

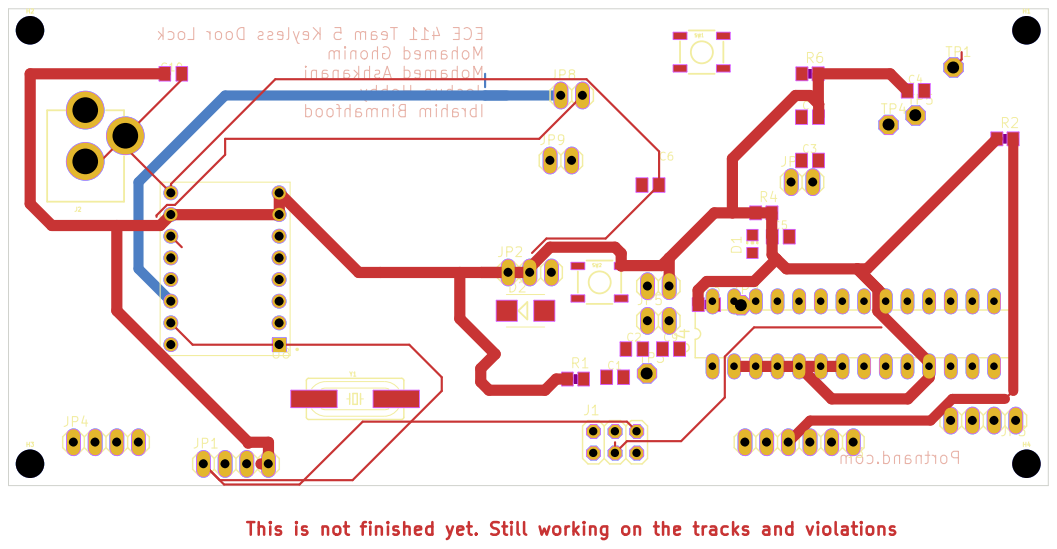
[picture p31: page 1]
