ECE411T5/Practicum/PCB Layout/Doorlock_PCB_Dark_BG.pdf

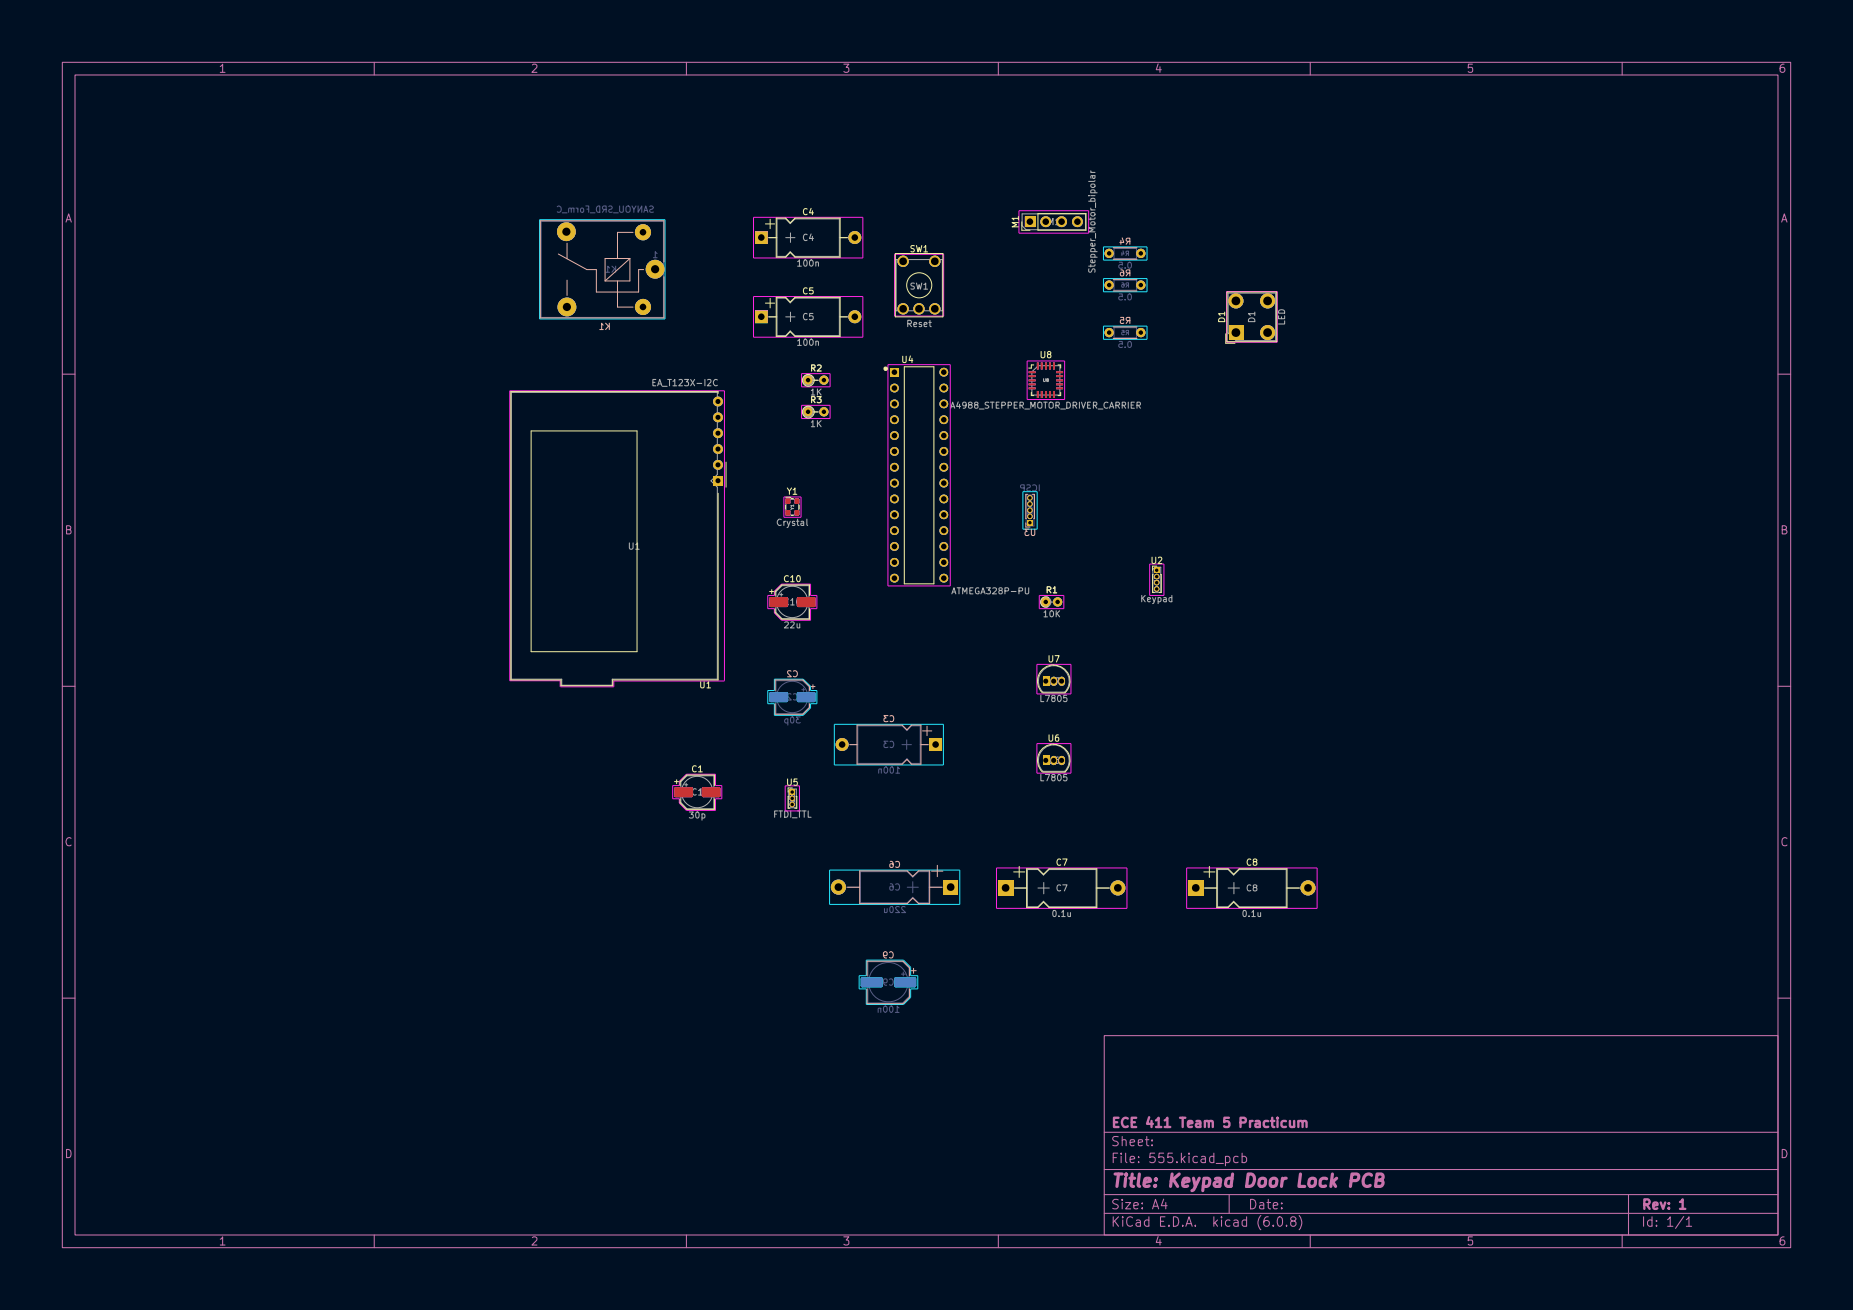
[picture p32: page 1]
