ECE411T5/Practicum/PCB Layout/Doorlock_PCB_White_BG.pdf

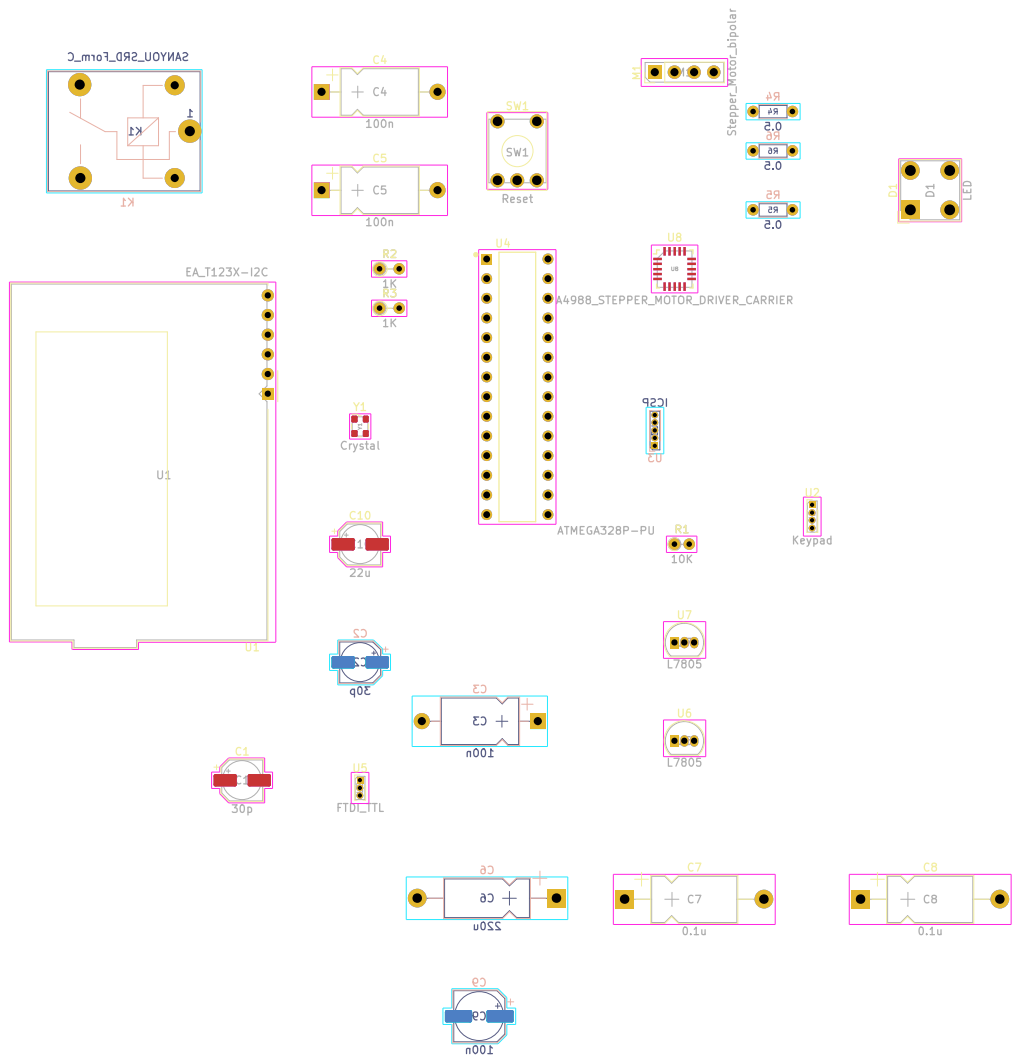
[picture p33: page 1]
