ECE411T5/Practicum/0 - Final CAD V2.3.1/0 - PDFs/1 - T05 - Final Layout V2.3.1_ALL_TECH_LAYERS_ON.pdf

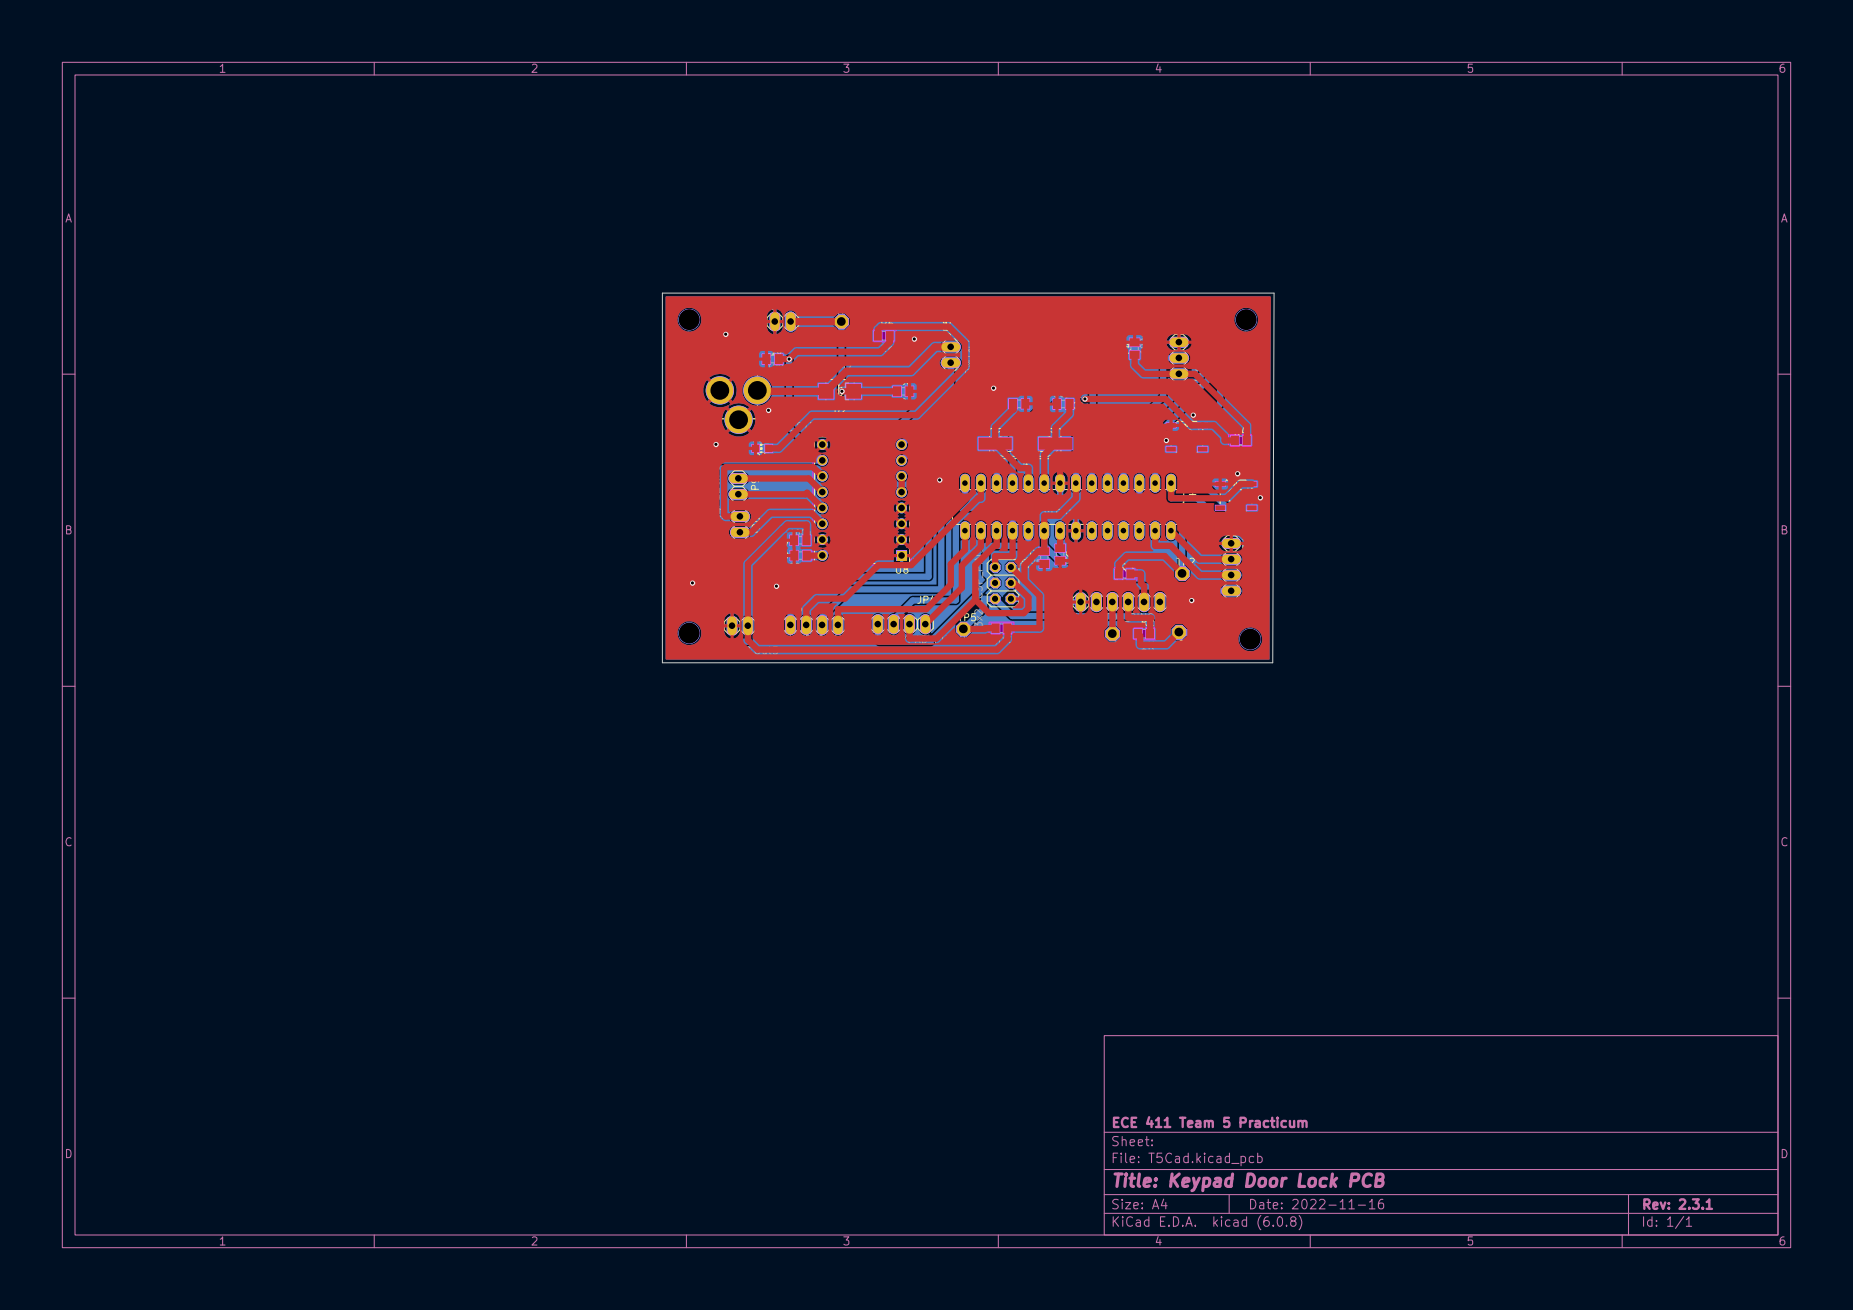
[picture p34: page 1]
