ECE411T5/Practicum/0 - Final CAD V2.3.1/0 - PDFs/T05 - Final Layout V2.3.1_BACK_LAYER_ONLY.pdf

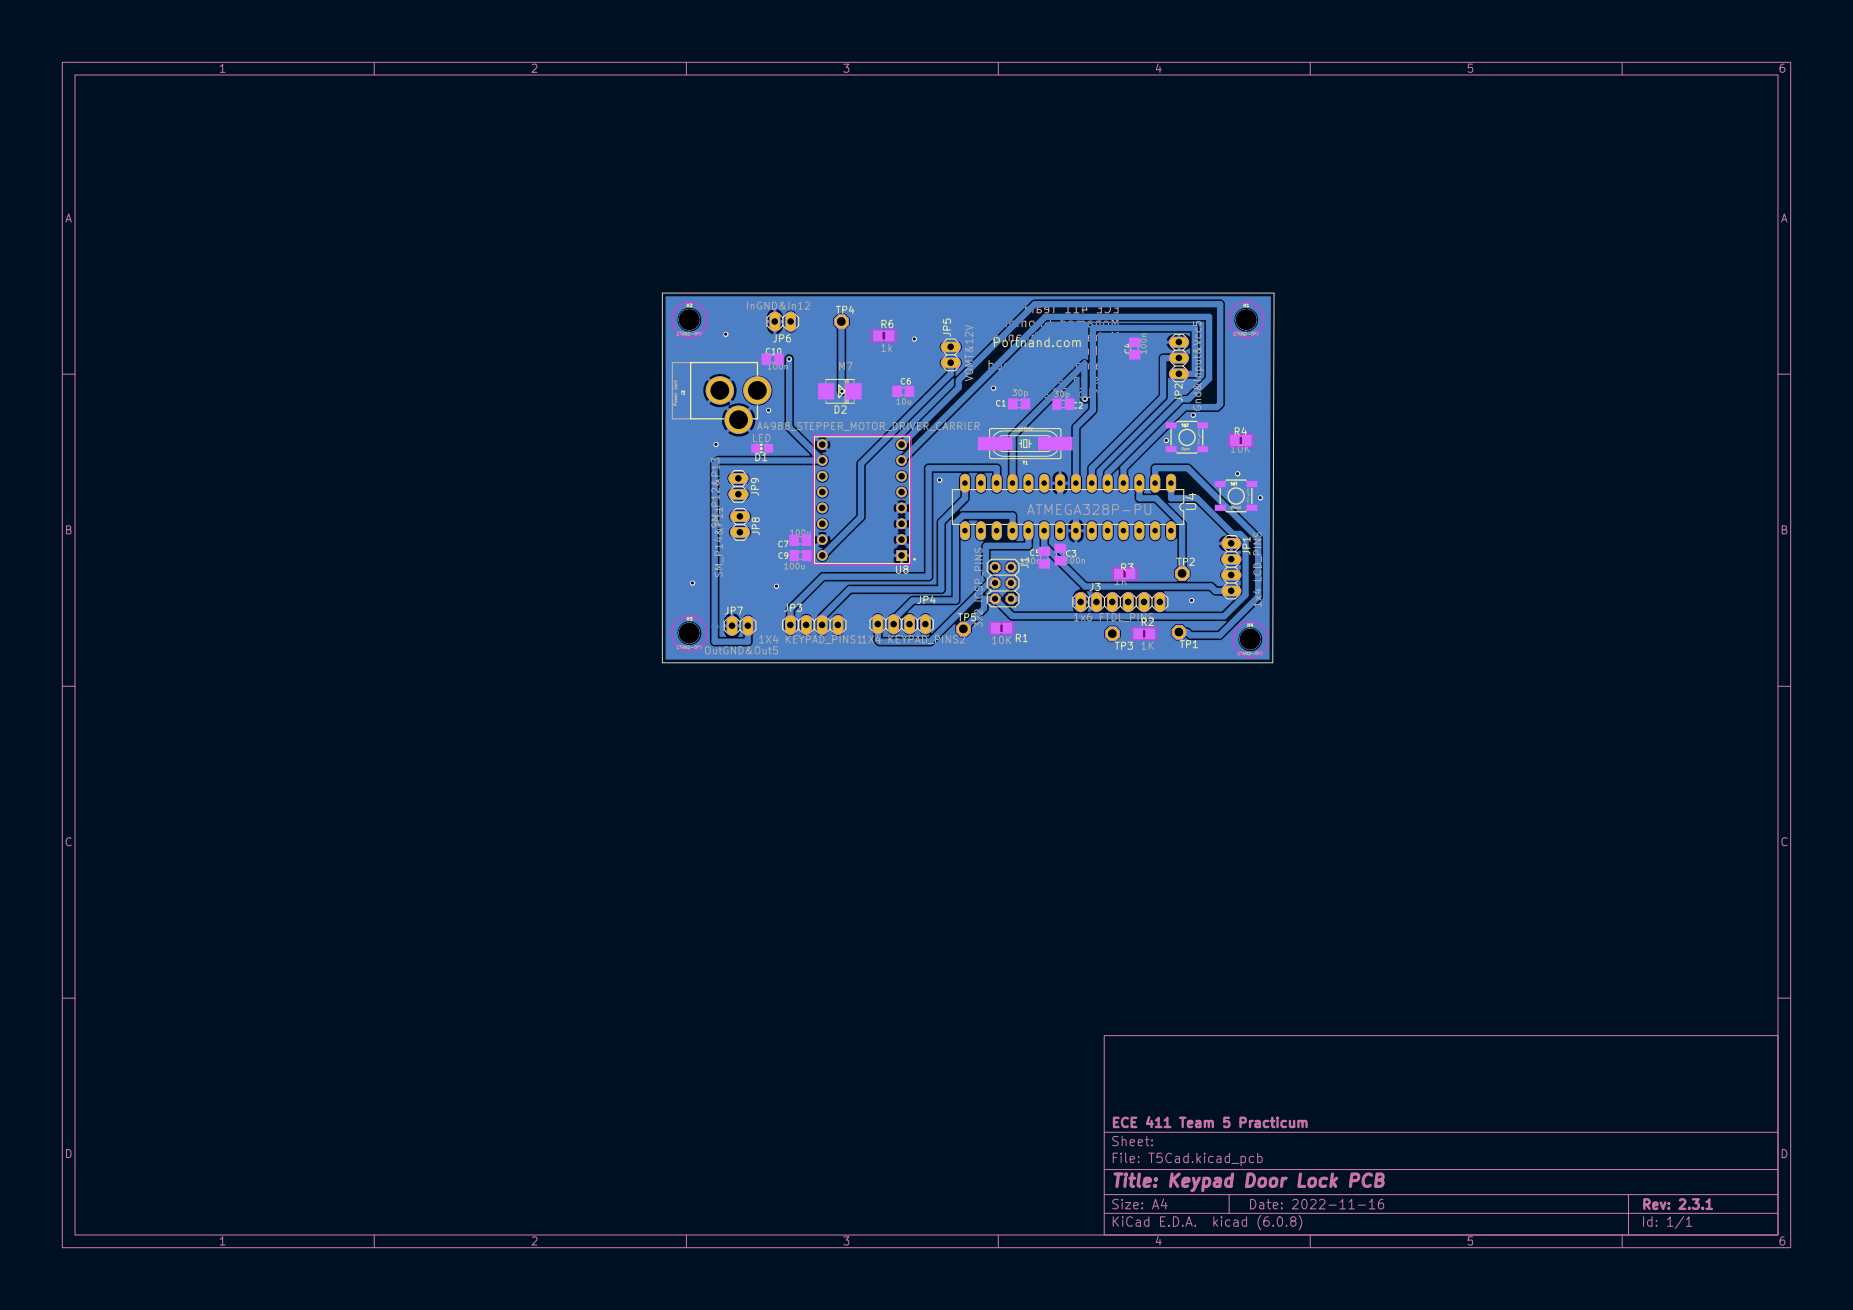
[picture p35: page 1]
