ECE411T5/Practicum/0 - Final CAD V2.3.1/0 - PDFs/T05 - Final Layout V2.3.1_FRONT_LAYER_ONLY.pdf

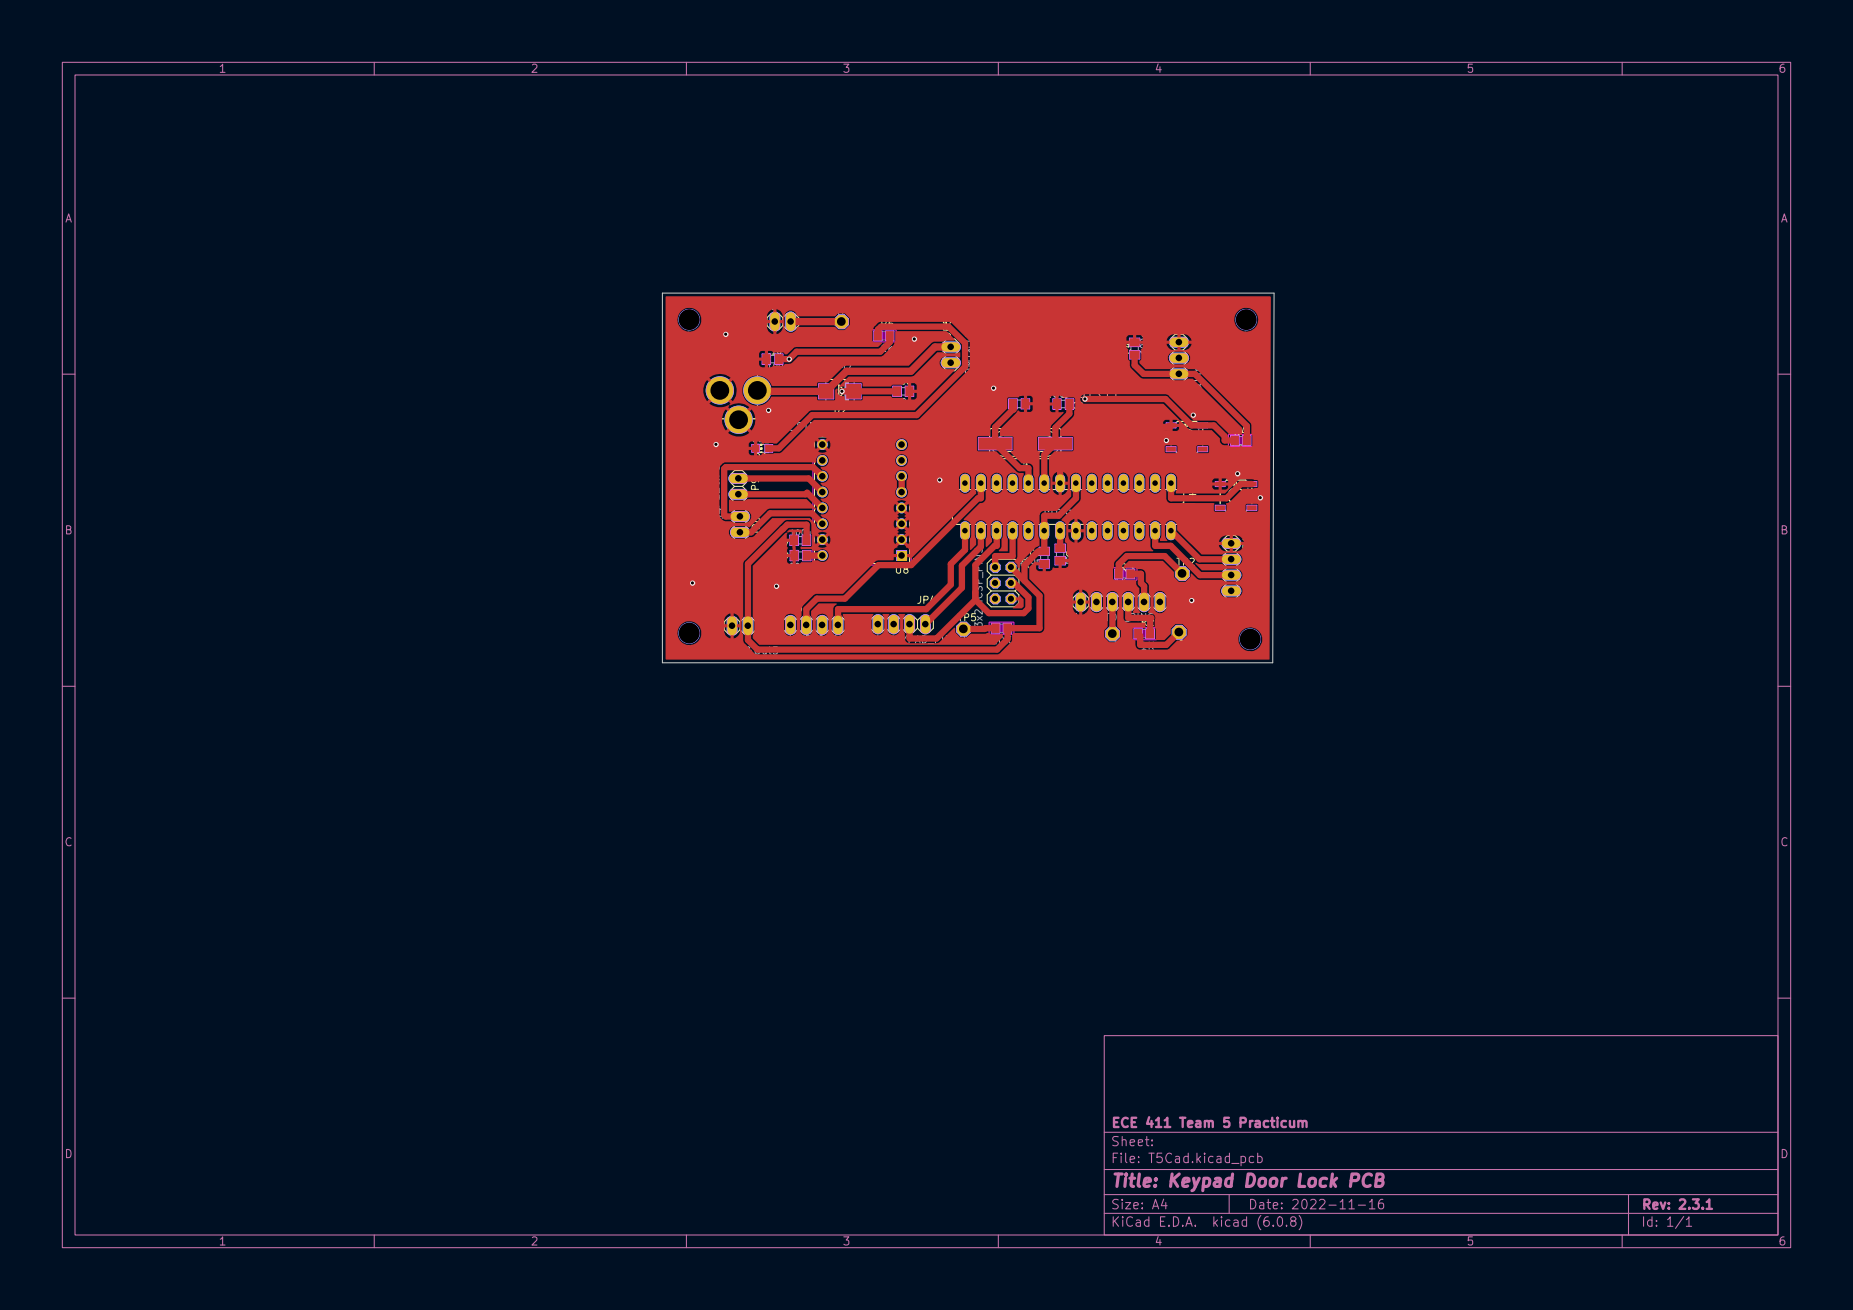
[picture p36: page 1]
