ECE411T5/Practicum/0 - Final CAD V2.3.1/0 - PDFs/T05 - Final Layout V2.3.1_NO_COPPER_LAYERS.pdf

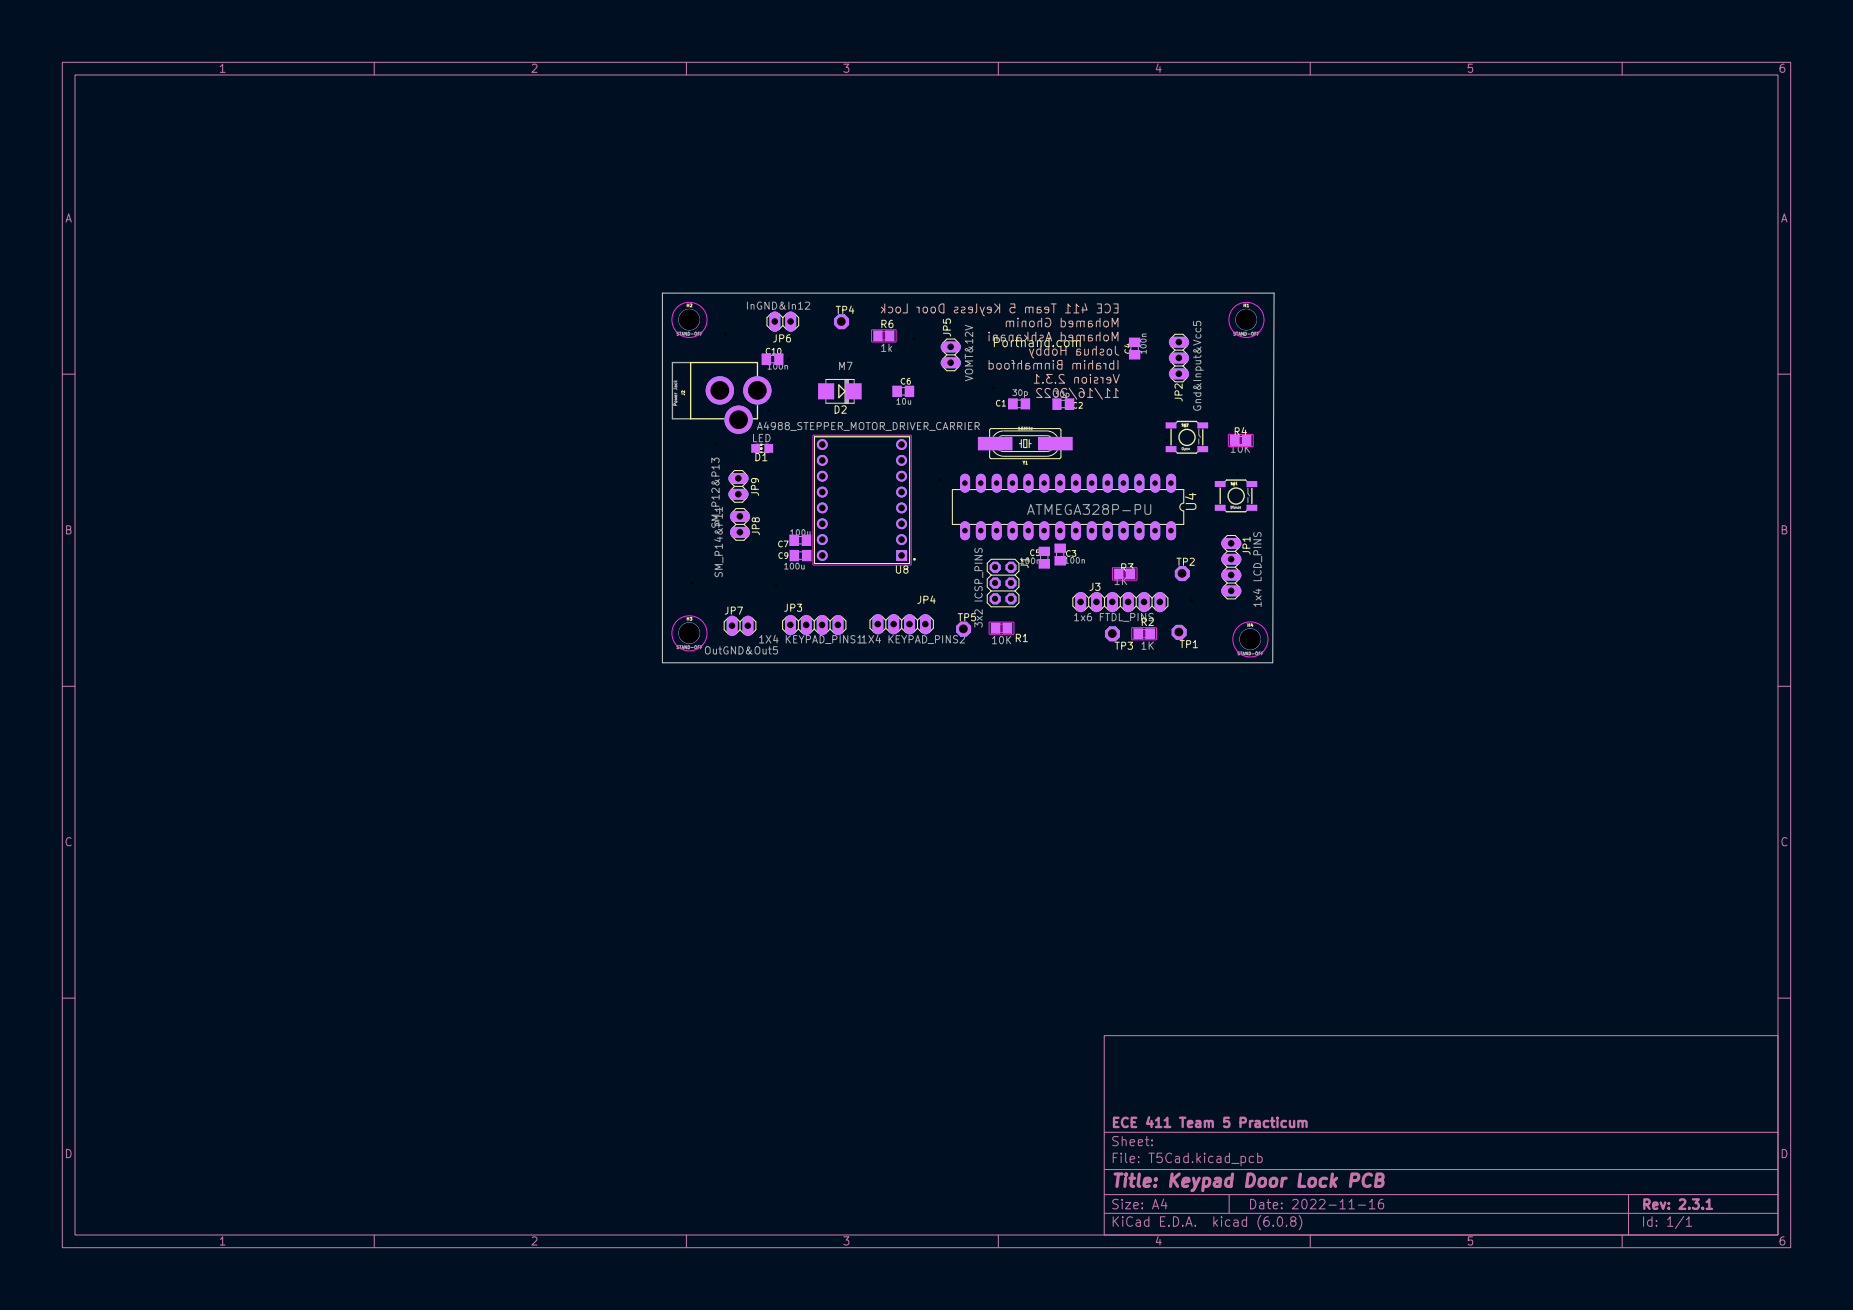
[picture p37: page 1]
