ECE411T5/Practicum/0 - Final Cad V1/All Components Layout.pdf

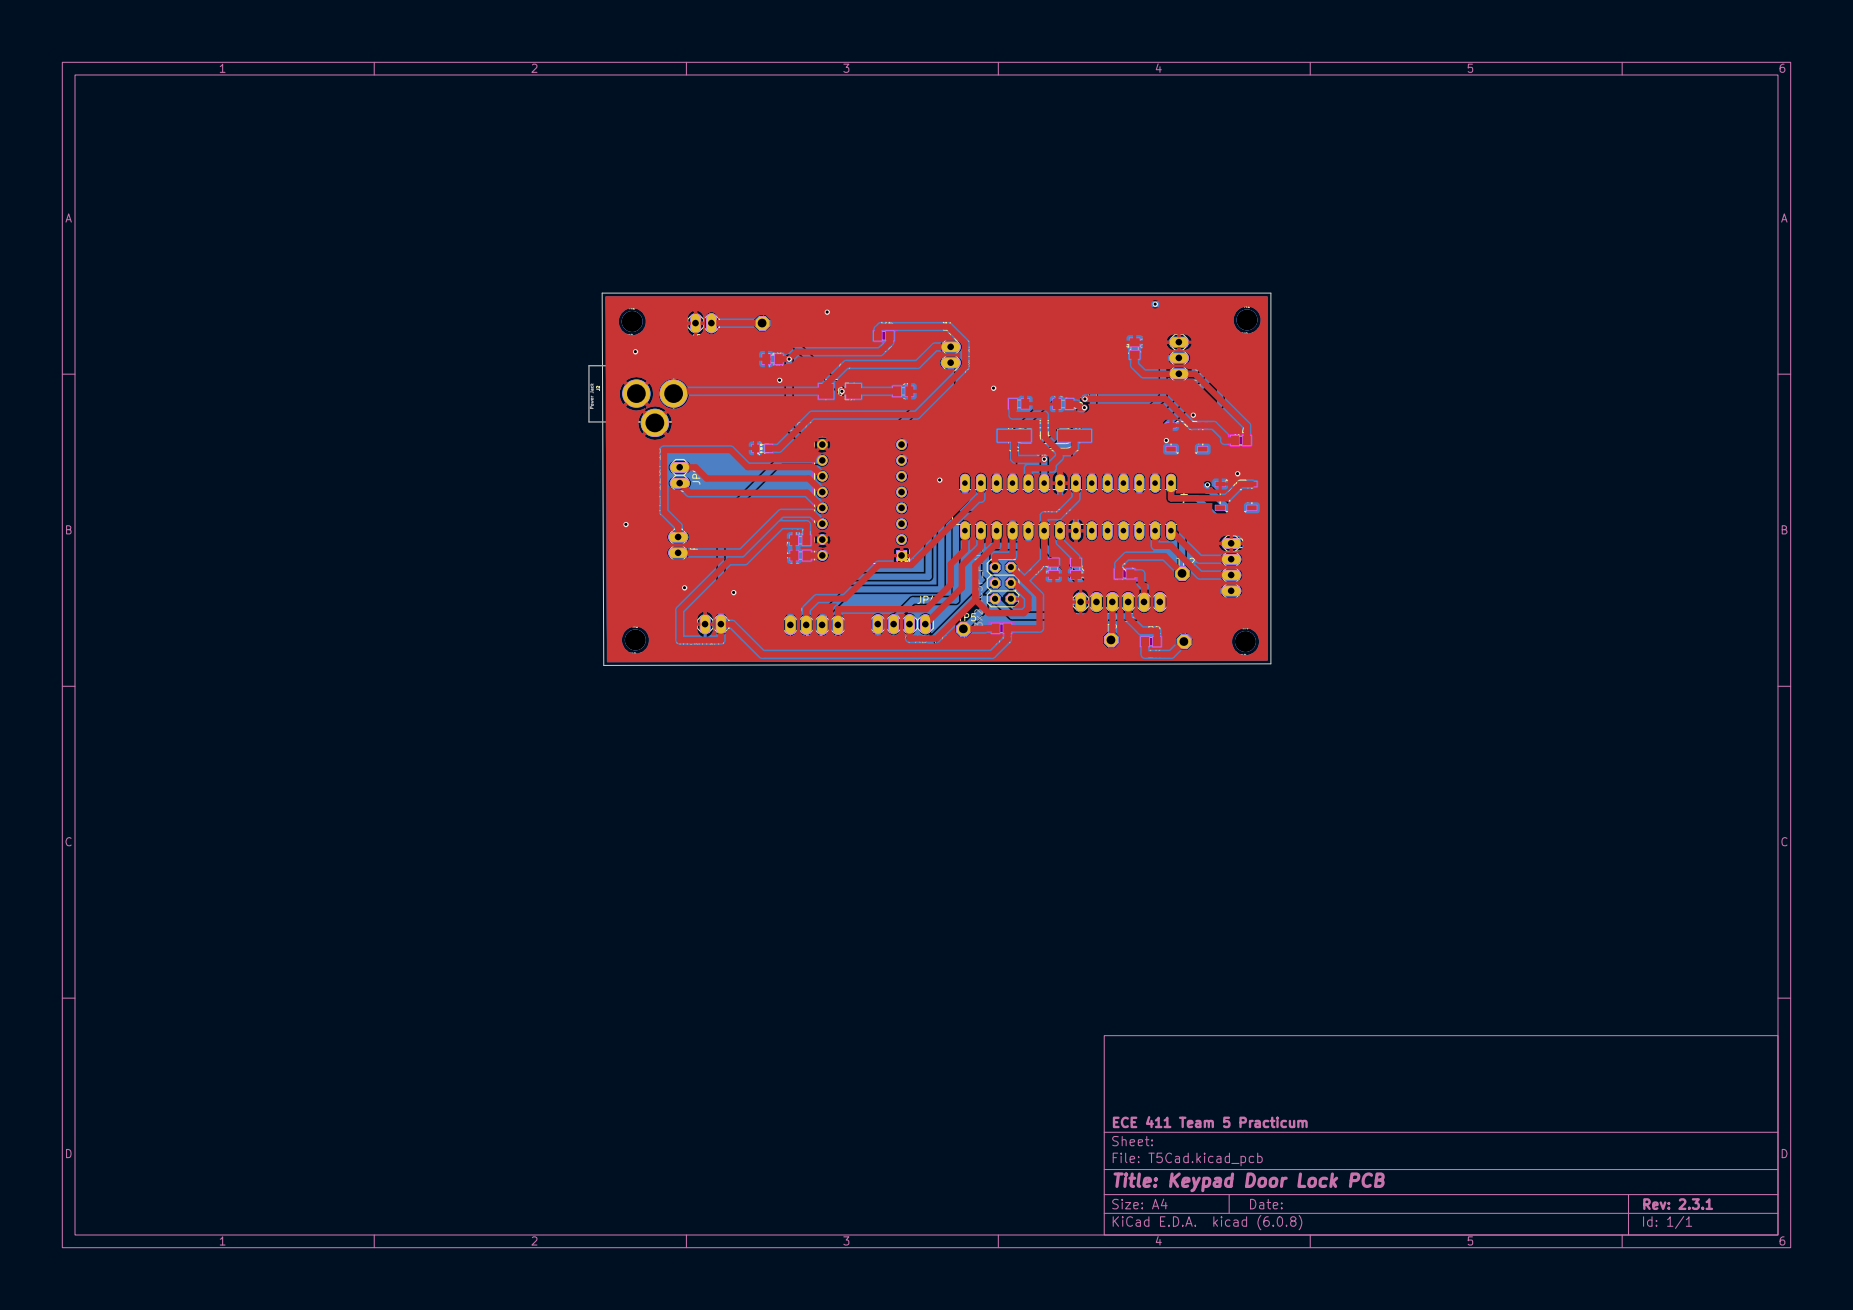
[picture p38: page 1]
