ECE411T5/Practicum/0 - Final Cad V1/Schematic.pdf

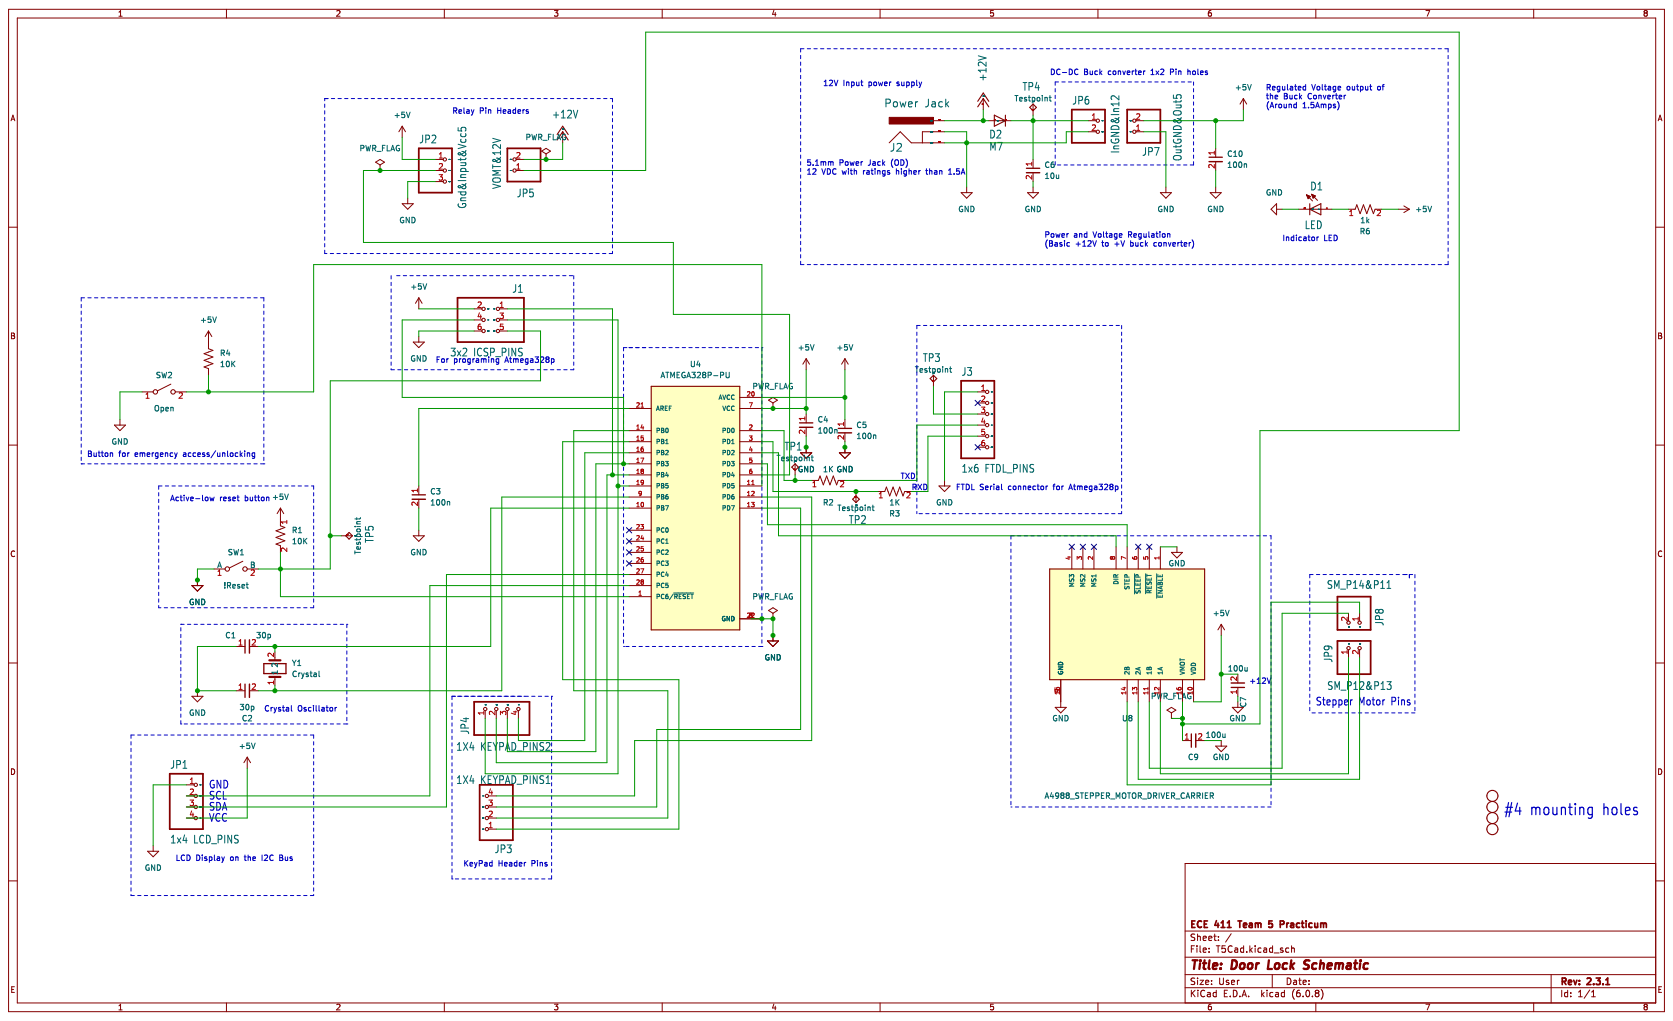
[picture p39: page 1]
