ECE411T5/Practicum/Z - CAD perfection is a million versions away/Final Iterations Nov 14/0-Interation/T5Cad.kicad_pcb

## KiCad design Z - CAD perfection is a million versions away/Final Iterations Nov 14/0-Interation/T5Cad.kicad_pcb (2022-12-01)

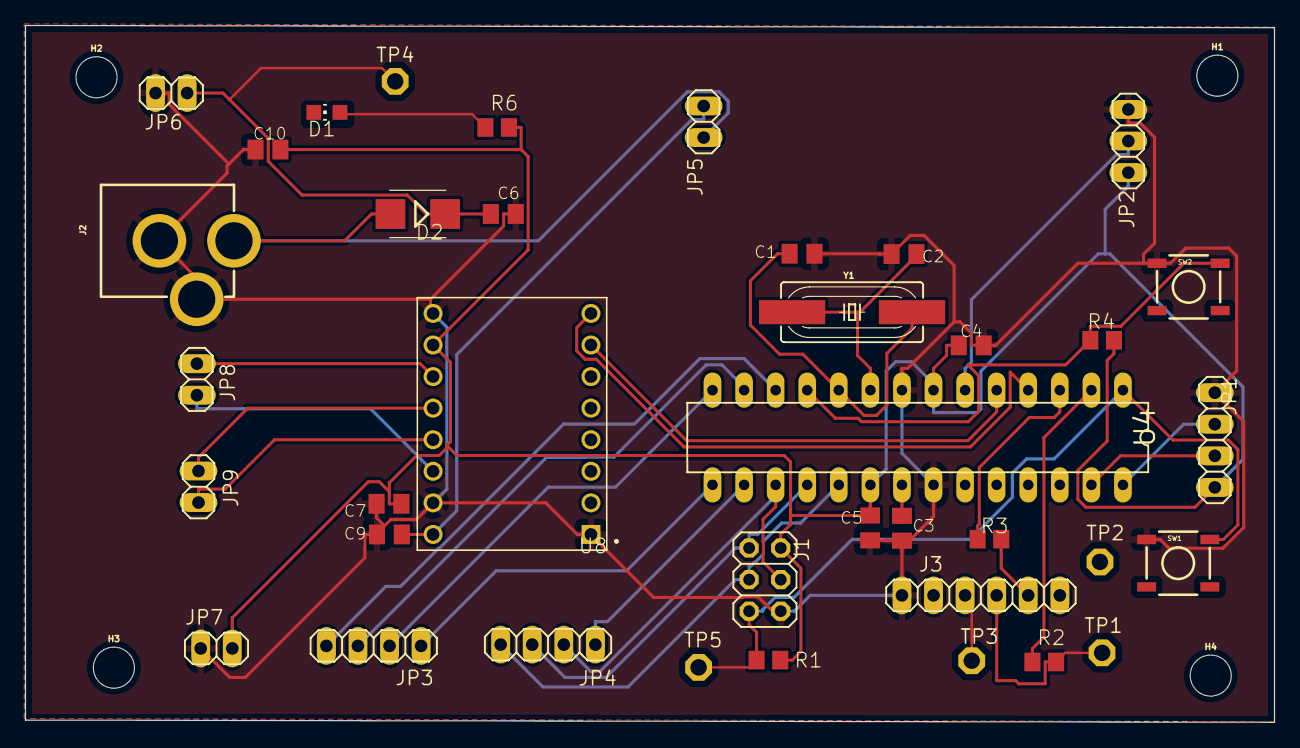
[picture p40: board T5Cad.kicad_pcb from above]

Board: 2 copper layers, 100.5 x 56.1 mm, 42 parts (0 on the bottom side), 32 nets.

Parts:
C1, C2: 30p; C0805K
C3, C4, C5, C10: 100n; C0805K
C6: 10u; C0805K
C7, C9: 100u; C0805K
D1: CHIP-LED0805
D2: SMB
H1, H2, H3, H4: STAND-OFF
J1: 2X03
J2: POWER_JACK_PTH
J3: 1X06
JP1: 1x4 Pin Conn.; 1X04
JP2: VCC.1 | IN1 | GND; 1X03
JP3, JP4: PINHD-1X4; 1X04
JP5: COM | NO; 1X02
JP6: IN- & IN+; 1X02
JP7: OUT- & OUT+; 1X02
JP8: 2B+ & 1B-; 1X02
JP9: 1A+ & 2A-; 1X02
R1, R4: 10K; R0805
R2, R3: 1K; R0805
R6: 1k; R0805
SW1: !Reset; TACTILE_SWITCH_SMD
SW2: Open; TACTILE_SWITCH_SMD
TP1, TP2, TP3, TP4, TP5: TestPoint; P1-13
U4: ATMEGA328P-PU; DIL28-3
U8: A4988_STEPPER_MOTOR_DRIVER_CARRIER; MODULE_A4988_STEPPER_MOTOR_DRIVER_CARRIER
Y1: Crystal; HC49UP

Connections:
+5V: C4.1, C5.1, C7.2, C10.1, J1.2, JP1.4, JP2.1, JP7.2, R1.1, R4.1, R6.2, U4.7 (VCC), U4.20 (AVCC), U8.10 (VDD)
+12V: D2.A, J2.PWR, JP5.2
GND: C1.1, C2.1, C3.2, C4.2, C5.2, C6.2, C7.1, C9.2, C10.2, D1.C, J1.6, J2.GND, J2.GNDBREAK, J3.1, JP1.1, JP2.3, JP6.2, JP7.1, SW1.1 (A), SW2.1 (A), U4.8 (GND), U4.22 (GND), U8.1 (~ENABLE), U8.9 (GND), U8.15 (GND)
unnamed: C1.2, U4.10 (PB7), Y1.2
unnamed: C2.2, U4.9 (PB6), Y1.1
unnamed: C3.1, U4.21 (AREF)
unnamed: C6.1, D2.C, JP6.1
unnamed: C9.1, JP5.1, U8.16 (VMOT)
unnamed: J1.1, JP4.2, U4.18 (PB4)
unnamed: J1.3, JP4.1, U4.19 (PB5)
unnamed: J1.4, JP4.3, U4.17 (PB3)
unnamed: J1.5, R1.2, SW1.2 (B), U4.1 (PC6/~RESET)
unnamed: J3.4, R2.2
unnamed: J3.5, R3.2
unnamed: JP1.2, U4.28 (PC5)
unnamed: JP1.3, U4.27 (PC4)
unnamed: JP2.2, U4.6 (PD4)
unnamed: JP3.1, U4.15 (PB1)
unnamed: JP3.2, U4.14 (PB0)
unnamed: JP3.3, U4.13 (PD7)
unnamed: JP3.4, U4.12 (PD6)
unnamed: JP4.4, U4.16 (PB2)
unnamed: JP8.1, U8.14 (2B)
unnamed: JP8.2, U8.11 (1B)
unnamed: JP9.1, U8.12 (1A)
unnamed: JP9.2, U8.13 (2A)
unnamed: R2.1, U4.2 (PD0)
unnamed: R3.1, U4.3 (PD1)
unnamed: R4.2, SW2.2 (B), U4.11 (PD5)
unnamed: D1.A, R6.1
unnamed: U4.4 (PD2), U8.8 (DIR)
unnamed: U4.5 (PD3), U8.7 (STEP)
