ECE411T5/Practicum/KiCAD Files Backup Nov 3rd/555.kicad_pcb

## KiCad design KiCAD Files Backup Nov 3rd/555.kicad_pcb (2022-11-03)

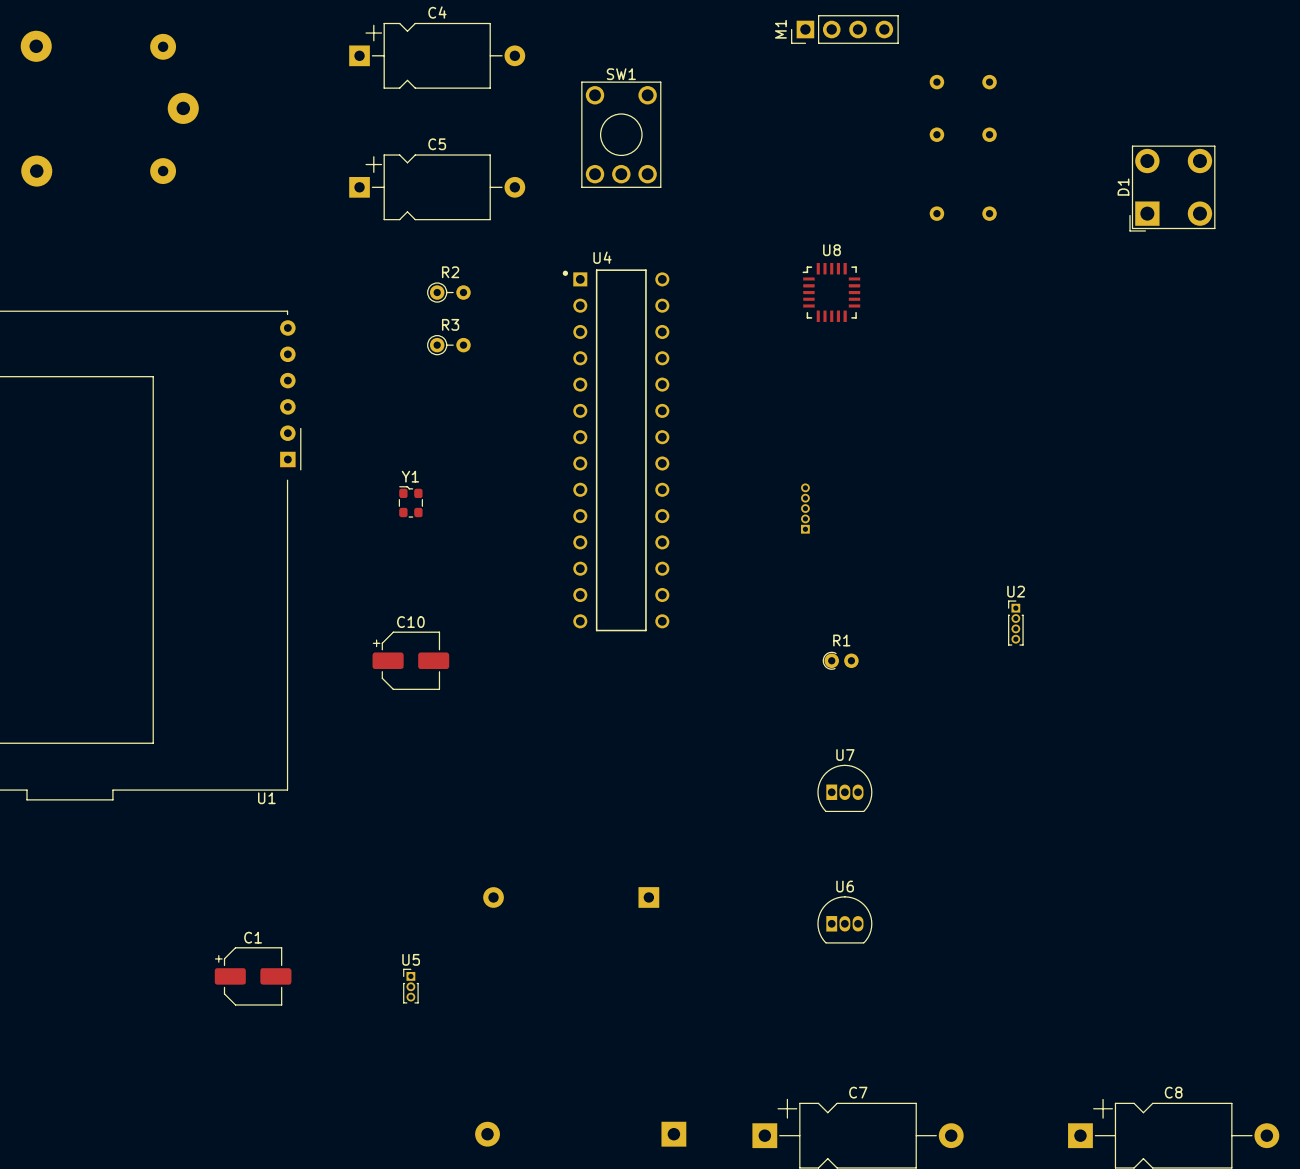
[picture p41: board 555.kicad_pcb from above]

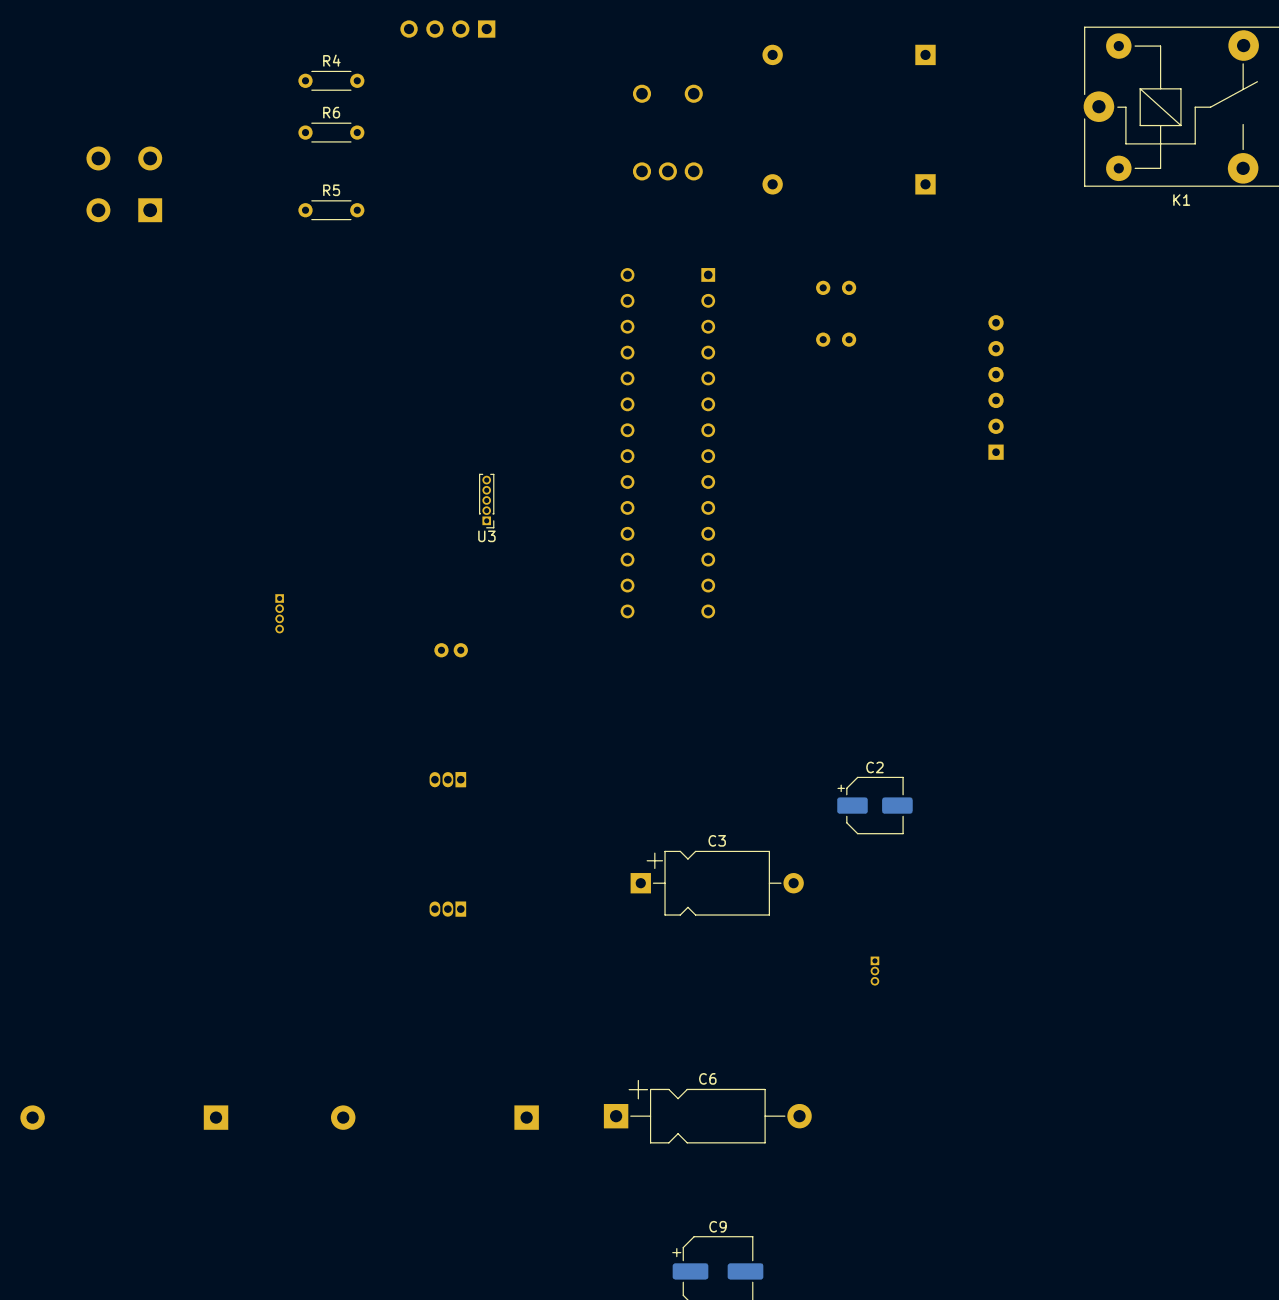
[picture p42: board 555.kicad_pcb from below]

Board: 2 copper layers, 29 parts (9 on the bottom side), 25 nets, no tracks yet.

Parts:
C1, C2: 30p; CP_Elec_5x4.5
C3, C4, C5: 100n; CP_Axial_L10.0mm_D6.0mm_P15.00mm_Horizontal
C6: 220u; CP_Axial_L11.0mm_D5.0mm_P18.00mm_Horizontal
C7, C8: 0.1u; CP_Axial_L11.0mm_D6.0mm_P18.00mm_Horizontal
C9: 100n; CP_Elec_6.3x3.9
C10: 22u; CP_Elec_5x5.8
D1: LED; LED_BL-FL7680RGB
K1: SANYOU_SRD_Form_C; Relay_SPDT_SANYOU_SRD_Series_Form_C
M1: Stepper_Motor_bipolar; PinHeader_1x04_P2.54mm_Vertical
R1: 10K; R_Axial_DIN0204_L3.6mm_D1.6mm_P1.90mm_Vertical
R2, R3: 1K; R_Axial_DIN0204_L3.6mm_D1.6mm_P2.54mm_Vertical
R4, R5, R6: 0.5; R_Axial_DIN0204_L3.6mm_D1.6mm_P5.08mm_Horizontal
SW1: Reset; KSA_Tactile_SPST
U1: EA_T123X-I2C
U2: Keypad; PinHeader_1x04_P1.00mm_Vertical
U3: ICSP; PinHeader_1x05_P1.00mm_Vertical
U4: ATMEGA328P-PU; DIP794W46P254L2967H457Q28B
U5: FTDI_TTL; PinHeader_1x03_P1.00mm_Vertical
U6, U7: L7805; TO-92_Inline
U8: A4988_STEPPER_MOTOR_DRIVER_CARRIER; AMS_LGA-20_4.7x4.5mm_P0.65mm
Y1: Crystal; Oscillator_SMD_ECS_2520MV-xxx-xx-4Pin_2.5x2.0mm

Connections:
+5V: C4.1, C5.1, C8.1, C10.1, K1.1, K1.2, R1.1, R4.2, R5.2, R6.2, U1.2 (VDD), U3.2, U4.7 (VCC), U4.20 (AVCC), U8.10 (VDD)
GND: C1.1, C2.1, C3.2, C4.2, C5.2, C6.2, C7.2, C8.2, C9.2, C10.2, D1.1 (K), K1.3, K1.4, SW1.1 (A), U1.1 (VSS), U4.8 (GND), U4.22 (GND), U5.1, U6.2 (GND), U7.2 (GND), U8.9 (GND), U8.15 (GND)
unnamed: C1.2, U4.10 (PB7), Y1.2
unnamed: C2.2, U4.9 (PB6), Y1.1
unnamed: C3.1, U4.21 (AREF)
unnamed: D1.2 (A), R6.1
unnamed: K1.5, U4.6 (PD4)
unnamed: M1.1, U8.12 (1A)
unnamed: M1.2 (-), U8.11 (1B)
unnamed: M1.3, U8.13 (2A)
unnamed: M1.4, U8.14 (2B)
unnamed: R1.2, SW1.2 (B), U3.5, U4.1 (PC6/~RESET)
unnamed: R2.1, U4.2 (PD0)
unnamed: R3.1, U4.3 (PD1)
unnamed: R4.1, U6.3 (OUT)
unnamed: R5.1, U7.3 (OUT)
unnamed: U1.5 (SDA), U4.28 (PC5)
unnamed: U1.6 (SCL), U4.27 (PC4)
unnamed: U2.1, U3.3, U4.19 (PB5)
unnamed: U2.2, U3.1, U4.18 (PB4)
unnamed: U2.3, U3.4, U4.17 (PB3)
unnamed: U2.4, U4.16 (PB2)
unnamed: U4.4 (PD2), U8.8 (DIR)
unnamed: U4.5 (PD3), U8.7 (STEP)
VDD: C6.1, C7.1, C9.1, U6.1 (IN), U7.1 (IN), U8.16 (VMOT)
