ECE411T5/Practicum/(commit log)

2022-11-14 Initial Prototype code and outline/buildsystem
2022-11-20 Using Arduino to prototype
2022-12-01 functioning code but keypad ordering is reversed (cols to rows)
    [Latest_ptype.ino]
2022-12-01 The initial protoype using the 1602A LCD Display without I2C and figuring things out
2022-12-03 Working Relay code, and RESET/UNLOCK button codes configured. Although, keymap formatting is still buggy and reversed
    [Latest_ptype.ino]
2022-12-08 latest stable code on breadboard prototype
